vbartusevicius/esp-measurement-platform/hardware/releases/v1/README.md

# ESP Measurement Platform Hardware v1 (1-DIN Universal Sensor Node + Plugin Enclosures)

Generated by `python3 hardware/scripts/build.py` from `hardware/circuits/variants/v1/` and `mechanical/scripts/`.
Release gate: KiCad DRC with 0 errors and 0 unrouted connections, pin-for-pin JLCPCB / EasyEDA footprint and
pin-name verification with live stock for every JLC-placed part, and the CadQuery fit tests in `mechanical/tests/`.
Independent pre-order review: `.claude/skills/manufacturing-readiness-review/` (run it before every order).

| View | Render |
| :---: | :---: |
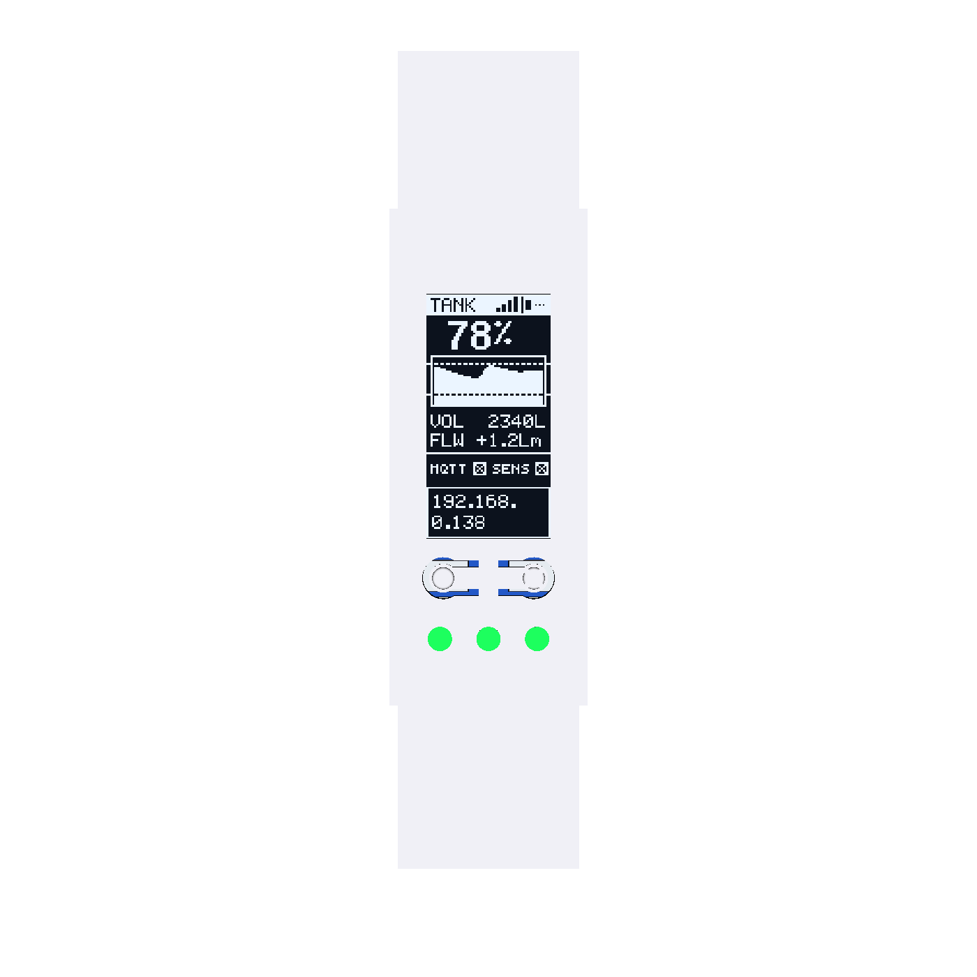
[picture p14: hardware/releases/v1/enclosure/renders/front.png]
Front
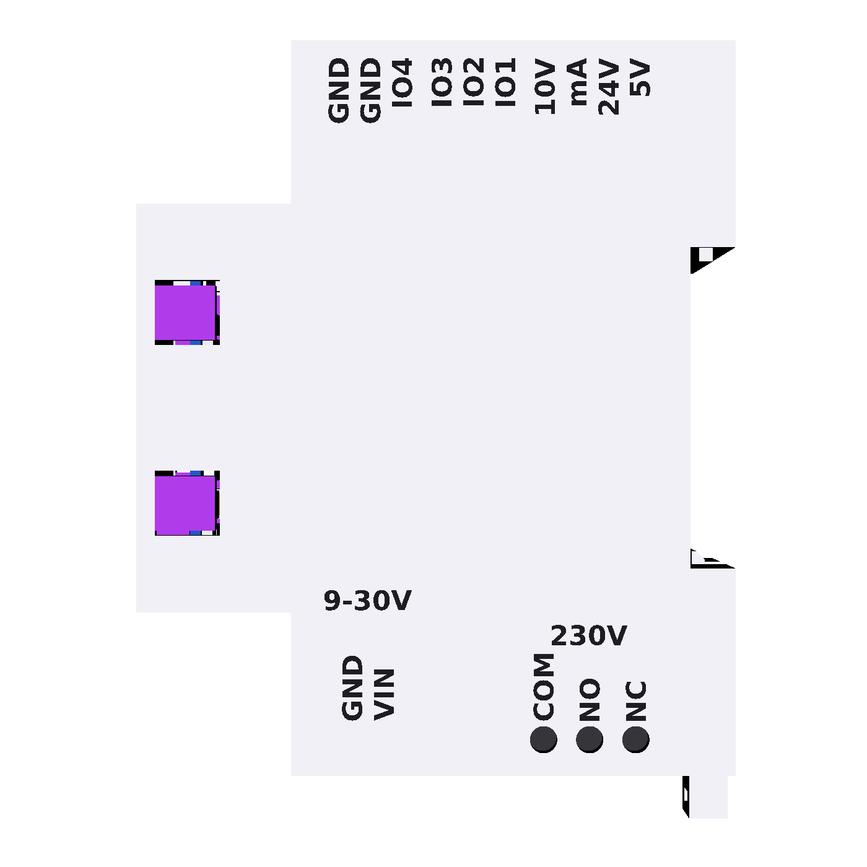
[picture p15: hardware/releases/v1/enclosure/renders/side.png]
Side
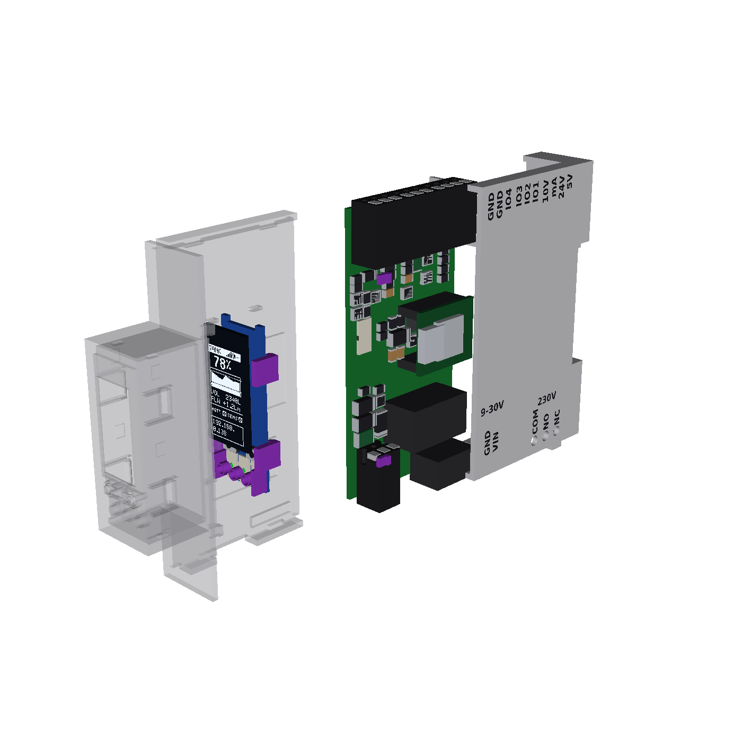
[picture p16: hardware/releases/v1/enclosure/renders/exploded.png]
Exploded
| **1-DIN Universal Sensor Node (Front, Side Legend & Exploded)** |    |
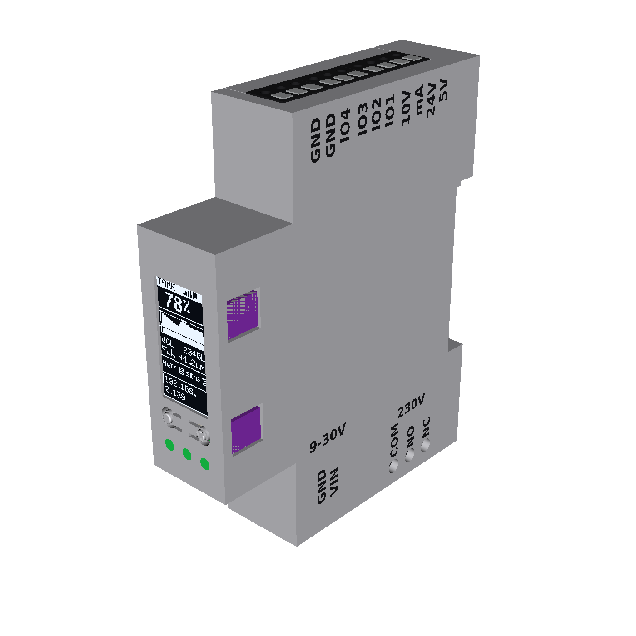
[picture p17: hardware/releases/v1/enclosure/renders/iso.png]
Iso
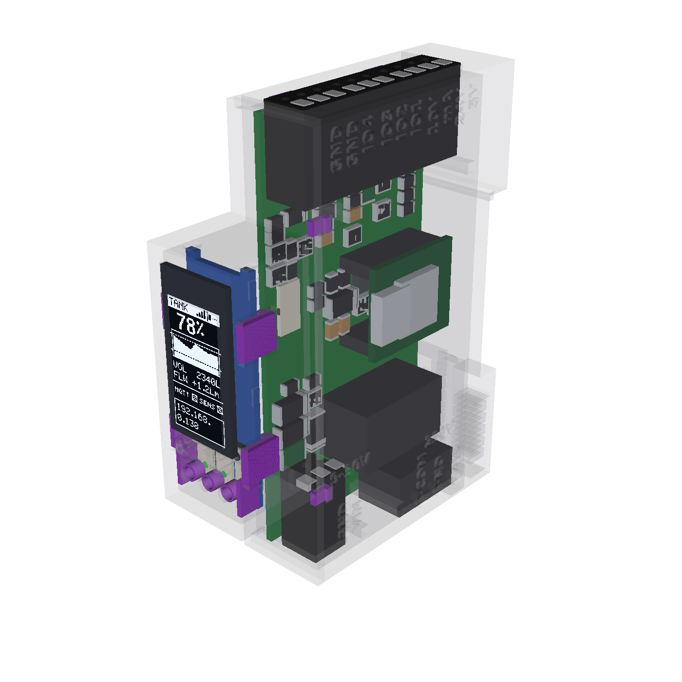
[picture p18: hardware/releases/v1/enclosure/renders/inside.png]
Inside
| **1-DIN Isometric & Internal Layout (`main` + `ui`)** |   |
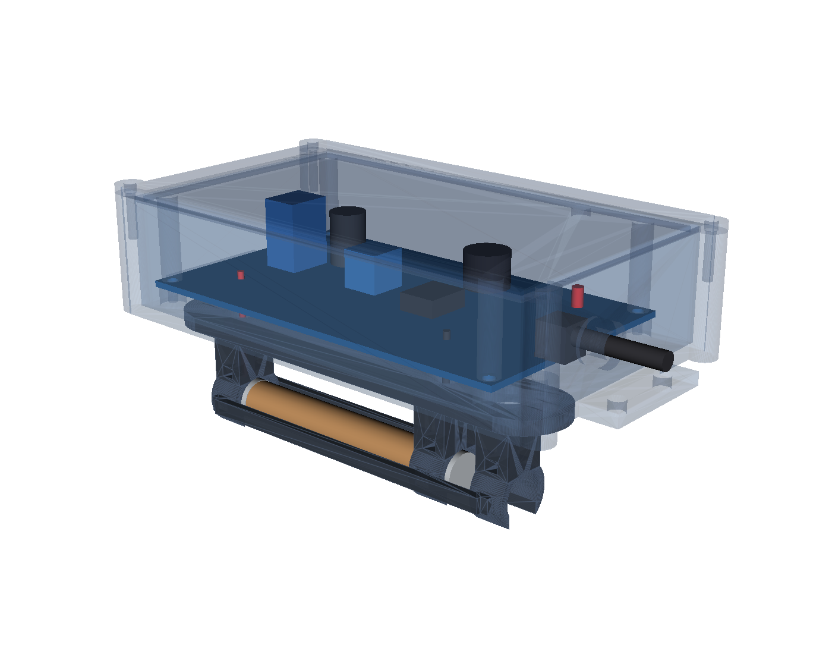
[picture p19: hardware/releases/v1/accessories/radiation_duct/renders/radiation_inside.png]
Radiation Inside
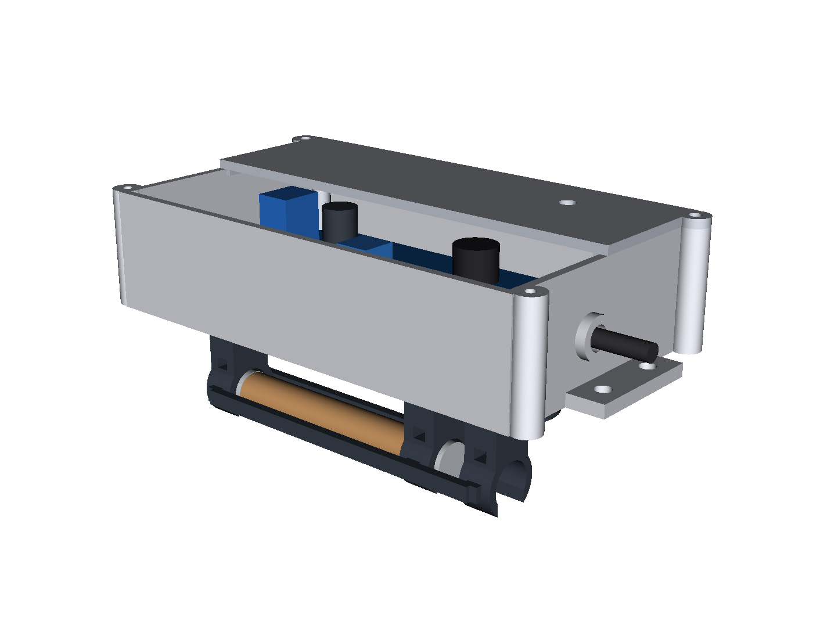
[picture p20: hardware/releases/v1/accessories/radiation_duct/renders/radiation_assembled.png]
Radiation Assembled
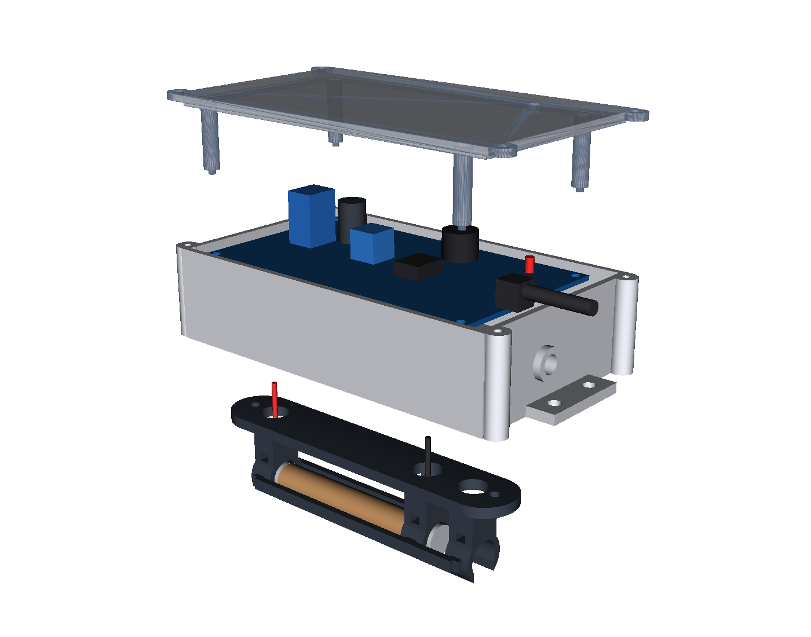
[picture p21: hardware/releases/v1/accessories/radiation_duct/renders/radiation_exploded.png]
Radiation Exploded
| **Radiation Counter Airduct Assembly** |    |
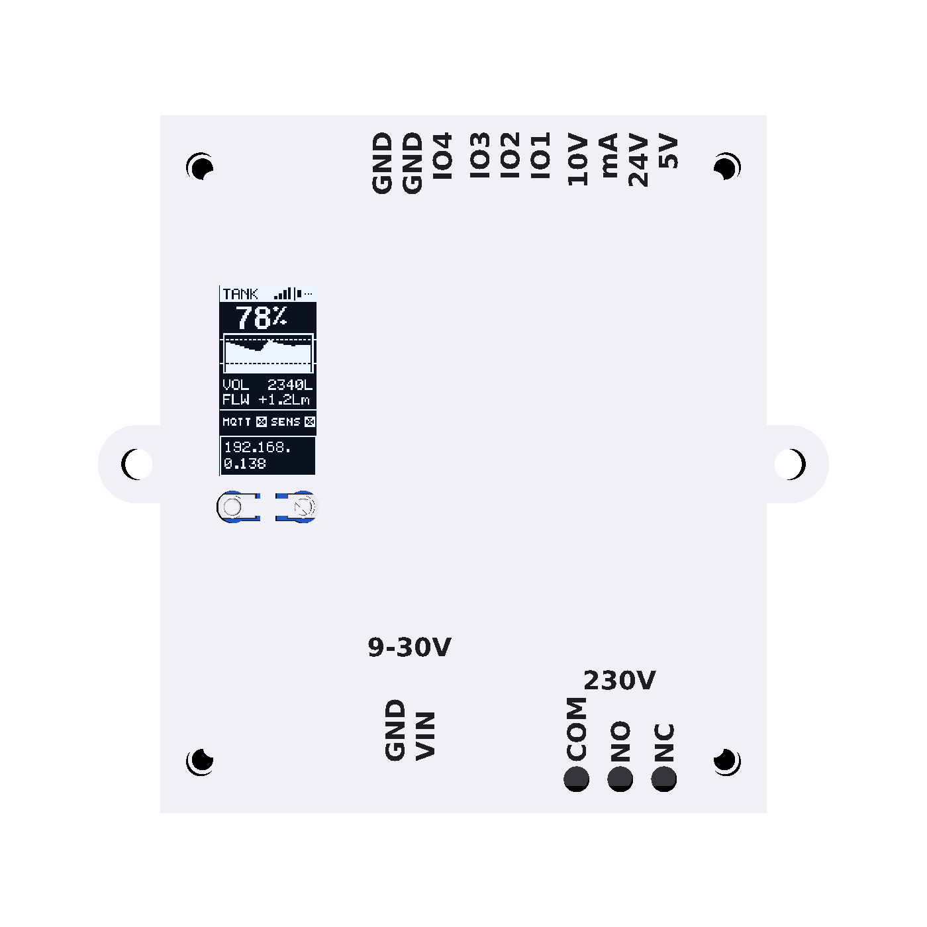
[picture p22: hardware/releases/v1/box_enclosure/renders/box_front.png]
Box Front
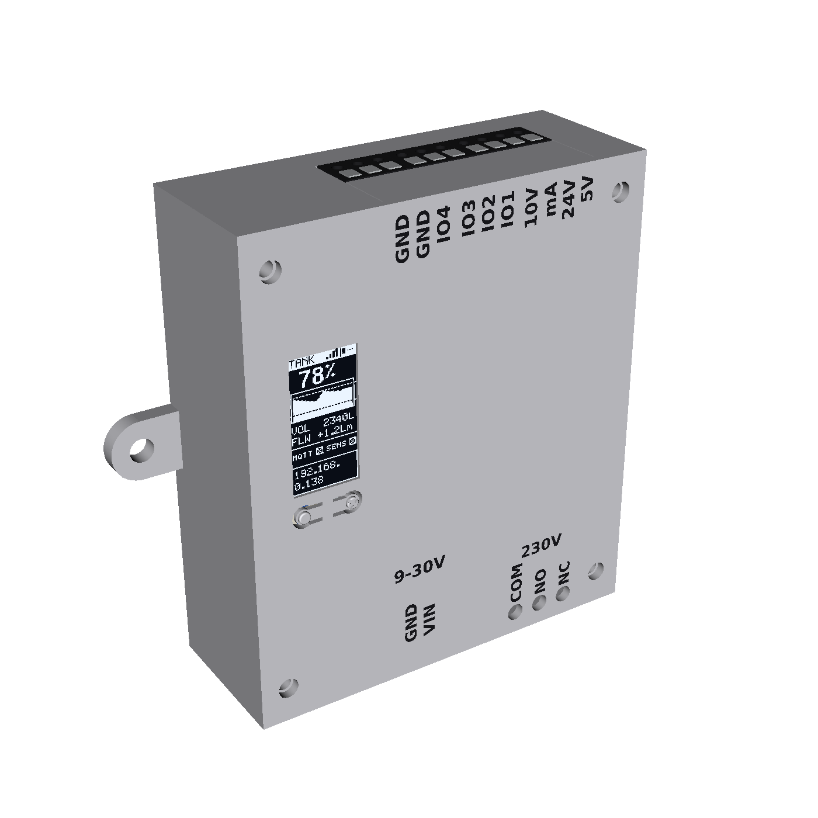
[picture p23: hardware/releases/v1/box_enclosure/renders/box_iso.png]
Box Iso
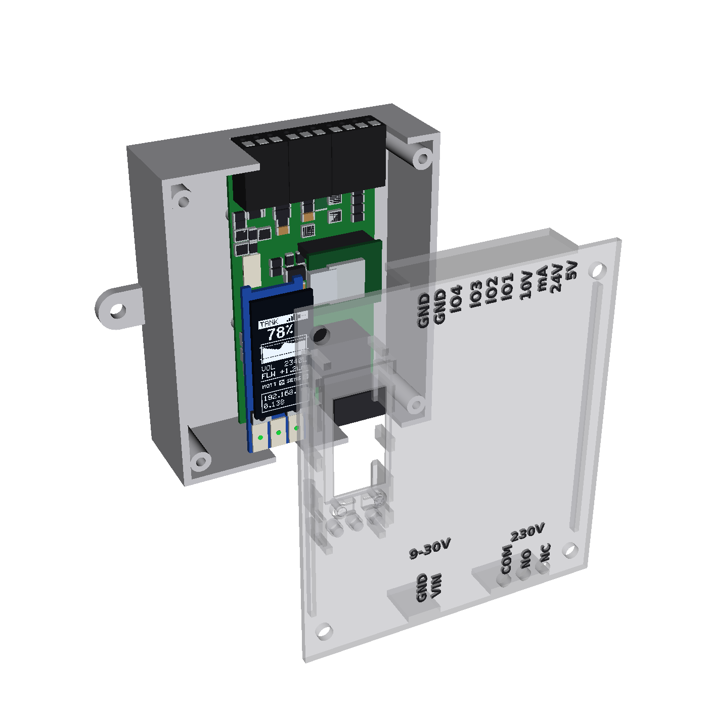
[picture p24: hardware/releases/v1/box_enclosure/renders/box_exploded.png]
Box Exploded
| **Wall-Mount Box (non-DIN alternative)** |    |
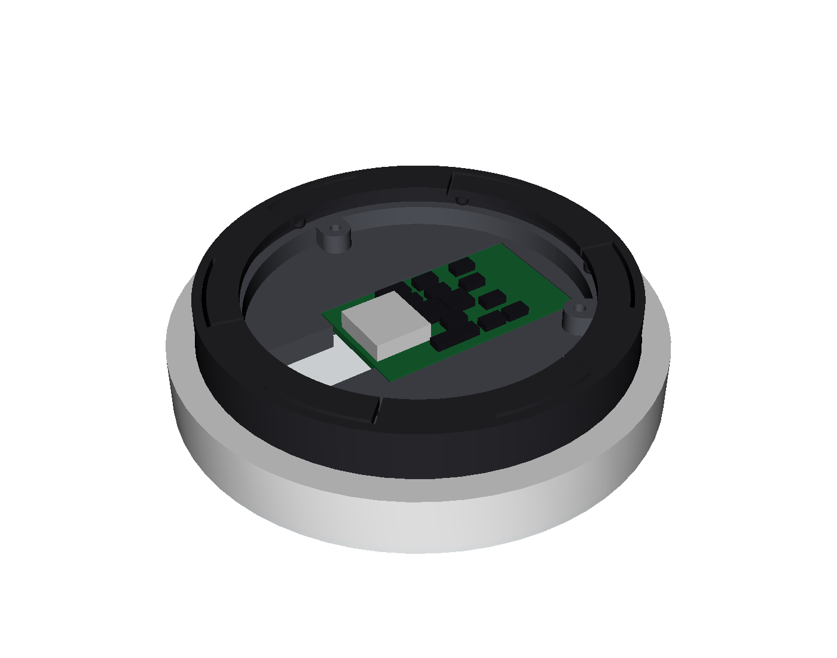
[picture p25: hardware/releases/v1/accessories/dial_reader/renders/dial_reader_inside.png]
Reader Inside
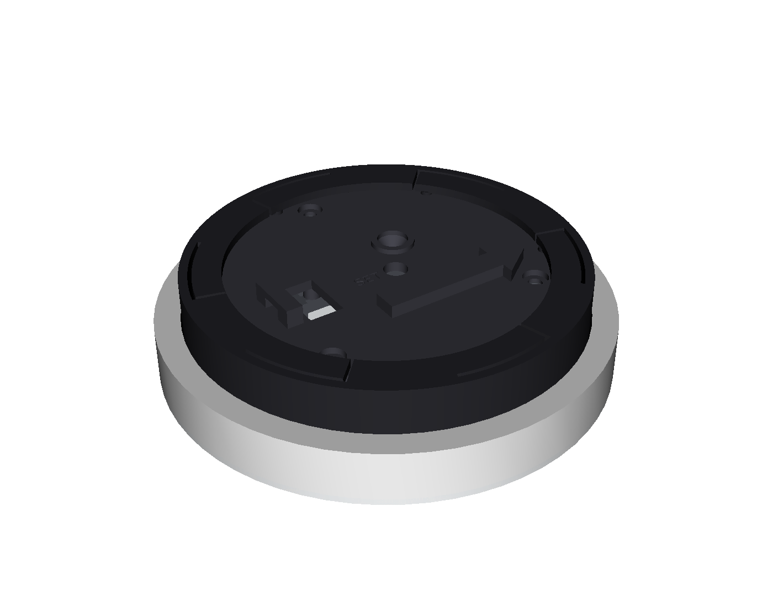
[picture p26: hardware/releases/v1/accessories/dial_reader/renders/dial_reader_assembled.png]
Reader Assembled
| **Optical Dial Reader (water / gas / oil dials)** |   Reader Exploded |
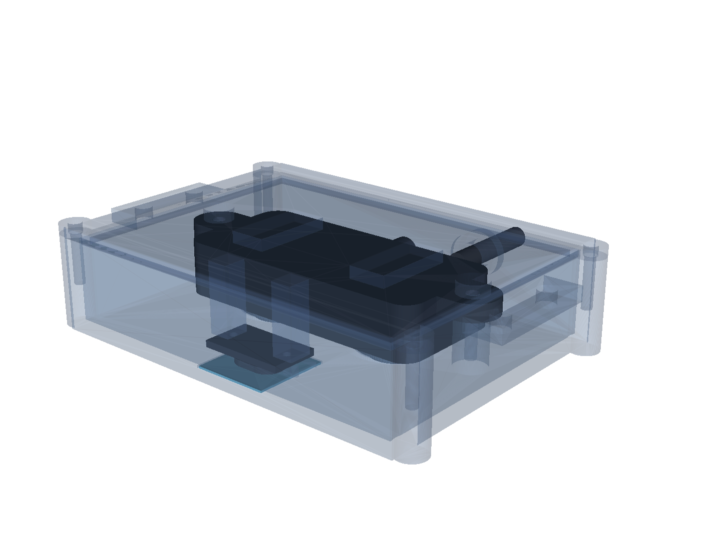
[picture p27: hardware/releases/v1/accessories/distance_sensor_pod/renders/distance_pod_inside.png]
Distance Pod Inside
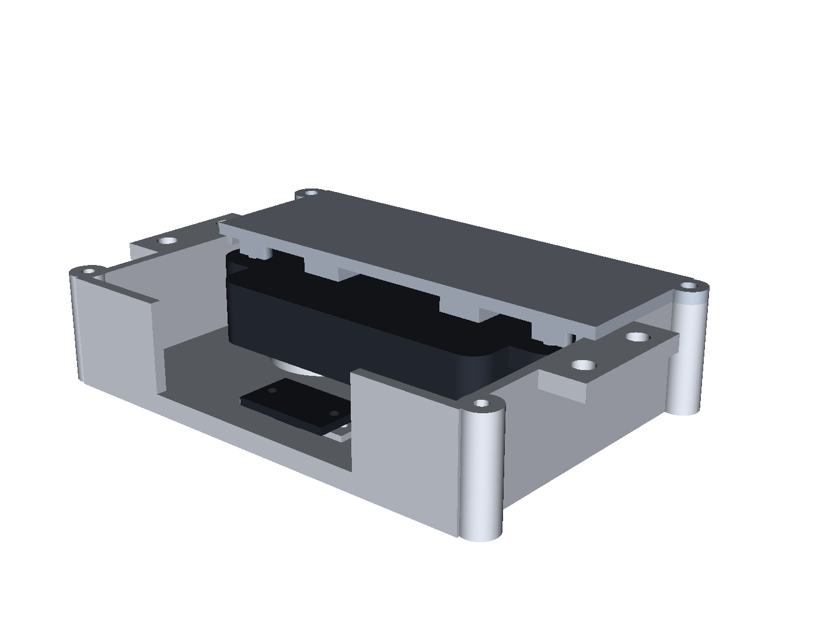
[picture p28: hardware/releases/v1/accessories/distance_sensor_pod/renders/distance_pod_assembled.png]
Distance Pod Assembled
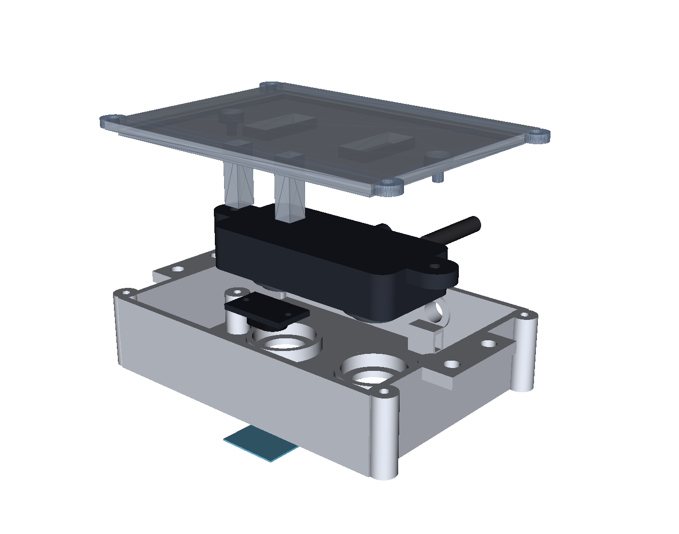
[picture p29: hardware/releases/v1/accessories/distance_sensor_pod/renders/distance_pod_exploded.png]
Distance Pod Exploded
| **Universal Distance Sensor Pod** |    |

### Which files to upload

Every board folder (`main/`, `ui/`, `reader/`) holds the same set; `<b>` is the board name.

| Fab | Bare PCB | Assembly (PCBA) |
|---|---|---|
| **JLCPCB** | `<b>_gerbers.zip` (or `panel/panel_gerbers.zip` for `main` + `ui` in one order) | `<b>_bom_jlc.csv` + `<b>_cpl_jlc.csv`: LCSC numbers, rotations and centres fitted to JLC's own footprints |
| **AISLER** | `<b>_odb.zip` (ODB++) | the same `<b>_odb.zip`: AISLER assembles only from ODB++ or native files, not from Gerbers. Parts auto-assign from the `MPN` field; hand-fit parts carry ODB++'s `.no_pop` flag |
| **Eurocircuits** | `<b>_odb.zip` or `<b>_gerbers.zip` | `<b>_bom.csv` + `<b>_cpl.csv` (they ignore the BOM inside CAD data and ask for a separate one) |
| **PCBWay** and most others | `<b>_gerbers.zip` | `<b>_bom.csv` + `<b>_cpl.csv`; `<b>_ipc2581.zip` (IPC-2581 C with the BOM) where accepted |

- **`<b>_gerbers.zip`:** Gerber X2 copper, mask, paste, silkscreen and outline, Excellon drills with plated and non-plated holes in separate files, the Gerber job file, and `<b>-netlist.ipc` (IPC-D-356) for the electrical test.
- **`<b>_bom.csv`:** grouped by part: Qty, Designator, Value, Manufacturer, MPN, LCSC, Package, SMD/THT, Place (`NO` = hand-fitted after assembly, e.g. the XIAO module) and a description.
- **`<b>_cpl.csv`:** every machine-placed part (hand-fit parts left out) in mm, in the Gerbers' coordinates. Rotations follow KiCad's footprint orientation: check polarised parts in the fab's placement preview, as with JLC.
- **Panel:** only JLCPCB gets the ready-made `main` + `ui` panel; other fabs take the two boards as separate designs.

### Parts for assembling one device yourself

**Where each part goes:** `<board>/<board>_assembly.pdf` (main, ui, reader). It has one page per populated side (the bottom is mirrored, as seen from below). Each page shows every part's outline with its reference and value, a red dot on pin 1 and `*` on hand-fitted parts. Parts of the same value share a colour. The last page lists the values with their colour, quantity, side and references, so you can solder one value at a time. Use it wherever the silkscreen reference had to be hidden. The PDF is vector, so zoom in on the small parts.

`hardware/scripts/parts_orders.py` writes these with every release and looks every LCSC number up live on LCSC: it reports numbers that don't exist, aren't on sale or are short of the quantity. Quantities cover one complete device (`main` + `ui` + `reader`).

| File | Upload to | Map the columns |
|---|---|---|
| `order_lcsc.csv` | [LCSC BOM Tool](https://www.lcsc.com/bom) | **LCSC Part Number** → "LCSC Part #", **Quantity** → "Quantity". Optional: **Manufacturer Part Number** → "Manufacture Part #", **Designators** → "Customer #" / comment. Leave **Value** and **Footprint** unmapped. LCSC raises each line to its minimum order itself (e.g. 100 for 0603 resistors). |
| `order_elsewhere.csv` | Electronics LCSC doesn't sell: pick one shop per line ([Mouser BOM Tool](https://www.mouser.com/bom/), [Digi-Key BOM Manager](https://www.digikey.com/en/mylists/), TME by hand) | Map that shop's column (**Mouser**, **Digi-Key** or **TME**) to its part-number field and **Quantity** to quantity. A line can list numbers at several shops; **Other source** is filled only when no shop number exists (the OLED). Includes the three WAGO terminal blocks: JLCPCB assembles them, but LCSC doesn't sell them. |
| `assembly_parts.csv` | — | Everything off the boards: modules, cables, printed parts and general utility items (foam tape, ...). Utility and printed items appear only here. |

- **One line per LCSC number** in `order_lcsc.csv`, with designators as `board:ref` (`off-board` for the XIAO sockets and the FFC cable).
- **Not in the order files:** printed parts and general utility items (tapes, screws); they are listed in `assembly_parts.csv`.
- **LCSC replacements (2026-10-29):** LCSC had no stock of C14663, C25804 and C28323 and doesn't sell C82401, all four only in JLCPCB's own assembly library. They were replaced in the circuit (`hardware/circuits/common.py`, `blocks/power_24v.py`) by same-package, same-rating parts both LCSC and JLCPCB stock:
  - C14663 → C149620 (YAGEO AC0603KRX7R9BB104, 100 nF 50 V X7R 0603);
  - C25804 → C98220 (YAGEO RC0603FR-0710KL, 10 kΩ 1 % 0603);
  - C28323 → C91185 (YAGEO CC0805KKX7R9BB105, 1 µF 50 V X7R 0805);
  - C82401 → C167838 (CJ FNR4020S220MT, 22 µH 4×4×2.0 mm shielded, 1.1 A Isat, 0.87 A Irms, 455 mΩ; the Sunlord part was 1.05 A / 0.62 A / 455 mΩ).
- **Distributor numbers:** checked by hand on 2026-10-29 and stored in `hardware/scripts/gen_circuits.py` (off-board parts) and `hardware/product/lcsc_unavailable.yaml` (assembled parts LCSC doesn't sell). Mouser and Digi-Key block automated lookups, so only the LCSC numbers are re-checked on each release.

---

## 1. Universal 1-DIN (`18 mm`) Sensor Controller (`main` + `ui`)

| Board | Size | Layers | Thickness | Role | Folder |
|---|---|---|---|---|---|
| **Breakaway Panel (`panel`)** | see `panel/` | 4 | 1.2 mm | Combined `main` + `ui` with mouse-bite tabs (1 PCB + 1 PCBA order) | `panel/` |
| Main (`main`) | 39.8 × 77.4 mm | 4 | 1.2 mm | Vertical board along the left wall (0.2 mm clearance to the 77.8 mm cavity at both ends). 24 V input: 1.1 A PTC, `SS36` 60 V reverse-polarity Schottky, `SMAJ30A` TVS (48.4 V clamp); `SCT2601` 4.5–60 V (65 V abs max) 700 kHz buck → 5.05 V / 600 mA with `SS36` catch diode and 22 µH `FNR4020S220MT` (4×4×2 mm, drop-in for Sunlord `SWPA4020S220MT`); `SS34` Schottky (SMA) into the XIAO ESP32-C6 (on 5 mm female headers); passives 0805 or larger for hand soldering; dedicated 4–20 mA input (50 mA PTC + 120 Ω shunt); 0–10 V input (22 k / 10 k); four protected digital channels (IO1–IO4); all six signal inputs clamped to GND/+3V3 by `BAT54S` (2 µA, 10 pF max); Omron `G6B-2114P-US DC5` relay (1a + 1b joined as a changeover) for **230 VAC loads up to 2 A**, 6 mm creepage + milled slot to the SELV side, 2.5 mm between the relay nets | `main/` |
| UI (`ui`) | 13.8 × 40.5 mm | 4 | 1.2 mm | 0.96" 64×128 SSD1312 OLED (`QG-6428TSWCG02` / `JLX12864OLED-S096W` / `NFP1312-15AY`, 14-pin 0.62 mm solder-tail FPC on `J2`), two Omron `B3U-1000P` switches under C-shaped spring tabs in the front wall, three `WS2812B-MINI-V3J` RGB LEDs with gull-wing legs below them, 0805 passives, 8-pin 0.5 mm FFC (`J1`) to `main J3` | `ui/` |

### Terminal Pinout & Plugin Wiring

Every wire enters parallel to the board, through the top or bottom face of the case.

- **Push-in terminals:** WAGO 2086 3.5 mm SMD, with the release push-buttons in the wire-entry face (300 V / 10 A UL, 0.14–1.5 mm², strip 8–9 mm). Top bank: `J2`, `J5`, `J6`, JLC-assembled. Bottom: `J1` (2086-1202), hand-soldered because JLC has no stock.
- **`J4` (230 V relay):** a Degson `DG127R-5.08-03P` screw terminal (IEC 250 V / 15 A, 0.75–1.5 mm², strip 6–7 mm, M2.5 at 0.4 N·m), JLC-assembled. Its screws are turned through the three holes in the case's right side, under the COM / NO / NC labels.
- **Why not push-in on `J4`:** a 5 mm push-in terminal rated ≥ 250 V would need its release where you can reach it in an 18 mm case. The Kefa KF142R's levers stand 13.7 mm, beyond the case side, where the next DIN module would hold them open; the one fitting Phoenix SPT-SMD part is sold only in reels of 300.

| Terminal | Location | Poles | Function |
|---|---|---|---|
| **Sensor bank: `J2` (2086-1204) + `J5` + `J6` (2086-1203) = 10 poles** | Top | **`1: +5V`** · **`2: +24V`** · **`3: 4-20mA`** · **`4: 0-10V`** · **`5: IO1`** · **`6: IO2`** · **`7: IO3`** · **`8: IO4`** · **`9: GND`** · **`10: GND`** | `1: +5V` (600 mA shared with the controller); `2: +24V` (input after PTC + reverse diode, loop supply); `3: 4-20mA` (`D1/GPIO1/ADC1_CH1`: 50 mA PTC, 120 Ω shunt, 4 mA = 0.48 V, 20 mA = 2.40 V, 24 mA = 2.88 V, 10 k + 100 nF RC); `4: 0-10V` (`D0/GPIO0/ADC1_CH0`, 22 k / 10 k divider, 10 V = 3.125 V); `5: IO1` (`D7/GPIO17`: ECHO / SDA / RX); `6: IO2` (`D6/GPIO16`: TRIG / SCL / TX); `7: IO3` (`D9/GPIO20`: Geiger PULSE); `8: IO4` (`D10/GPIO18`: meter pulse); IO lines: 4.7 k pull-up to 3.3 V, 330 Ω series, `BAT54S` clamp |
| **`J1` (2P)** | Bottom front | **`1: GND`** · **`2: VIN+`** | `9–30 V DC`; 1.1 A PTC, `SS36` reverse protection, `SMAJ30A` surge clamp |
| **`J4` (3P)** | Bottom rear | **`1: COM`** · **`2: NO`** · **`3: NC`** | **230 VAC, 2 A resistive / 1.5 A inductive (cos φ 0.4)**. Omron G6B-2114P: 5 A 250 VAC rated, 3,000 VAC for 1 min and 6 kV impulse between coil and contacts, 11.0 mm tall. Coil pads sit 10.16 mm from the contact pads, with ≥ 6 mm PCB creepage and a milled slot. Fuse the load circuit at ≤ 2 A. The relay is off at power-up and after every reset. |

1. **2-wire 4–20 mA probe (e.g. `SWK-LT100`):** `Red (+)` → pole `2 (+24V)`, `Black (-)` → pole `3 (4-20mA)`. Loop compliance at 20 mA ≈ V<sub>IN</sub> − 0.5 V (diode) − 1.0 V (PTC) − 2.4 V (shunt): ≥ 20 V at 24 V input, ~8 V at 12 V input — check the transmitter's minimum supply.
2. **`0.4–4.5 V` (150 PSI) or `0–10 V` / `2–10 V` sensor:** `+5V`/`+24V` supply, `GND`, signal → pole `4 (0-10V)`. Ratiometric 5 V sensors follow the ±2.5 % buck tolerance (5 V is not measured).
3. **ToF `VL53L1X`/`TOF200C` (I²C) or `A02YYUW` (UART):** `VCC` → pole `1`, `GND` → pole `9`, `SDA/TX` → pole `5 (IO1)`, `SCL/RX` → pole `6 (IO2)`. Keep I²C cables short (≤ 1 m at 100 kHz with the 4.7 k pull-ups).
4. **CAJOE `RadiationD-v1.1`:** `+5V` → pole `1`, `GND` → pole `9`/`10`, `VIN (PULSE)` → pole `7 (IO3)`.
5. **Meter pulse emitter (B METERS `IWM-PL3`, open collector, max 30 V / 100 mA):** `White` (counting contact) → pole `8 (IO4)`, `Brown` (common) → pole `9`/`10 (GND)`; yellow and green unused. The 4.7 k pull-up gives 0.7 mA through the closed contact.
6. **230 VAC load on the relay:** phase from a ≤ 2 A fuse/MCB → `J4.1 (COM)`, load → `J4.2 (NO)` (or `J4.3 (NC)` for normally-on), load return to neutral directly (not through the device). Use 0.75–1.5 mm² wire, strip 11 mm. Control it from Home Assistant (auto-discovered **Relay** switch) or MQTT `<device_name>/relay/set` = `ON`/`OFF`; state on `<device_name>/relay`.

> **Mains safety:** installing this requires a qualified person and a closed distribution board.
> - **Enclosure material:** print the enclosure in a flame-retardant filament (UL94 V-0, e.g. PC-FR or PETG-V0) when J4 carries mains. Plain PETG/ASA is not flame-rated.
> - **Insulation:** the G6B's 3 kVAC / 6 kV coil–contact insulation plus the 8 mm PCB creepage is the barrier between 230 V and the SELV side. Omron does not market the G6B as "reinforced", and nothing here is a certified product.

---

### Printing the 1-DIN case (`enclosure/`, `box_enclosure/`)

- **Process:** sized for powder printing (MJF / SLS, PA12). Every gap inside one printed part is at least 0.6 mm (`MIN_PRINT_GAP`): the DIN latch and its springs, the button C-slots, the UI snap-tongue slots. The 0.2 mm clearances (`FDM_CLEAR`) are only between separately printed parts or between a part and a PCB / terminal body, which cannot fuse.
- **DIN latch:** a 3.6 mm bar on two 11-leg serpentine springs (0.6 mm legs, ≤ 2.5 % strain over the 1.8 mm release travel). Release it with a flat screwdriver in the 3.0 × 1.6 mm hole of the tab below the case.
- **Cover:** six snap clicks (two on the right wall, a pair at each end of the left edge). Its locating lip is bonded to the side wall along its length and notched clear of the snap tongues. Ribs on its left wall back the main board at least every 40 mm, and four base posts support the board's front face, 0.1 mm short, in part-free columns.
- **Front:** no text. The buttons are told apart by their pads: the plain round bump (●) is the page / acknowledge button, the bump with a recessed ✕ (1.5 mm bars, 0.5 mm wide, 0.35 mm deep) is reset / WiFi (tap: reboot; hold 5 s: WiFi setup; hold 15 s: factory reset). The three LEDs are unmarked: STATUS, NET, SENS from left to right. The UI board is held off the front by edge stops beside the LED row.
- **Right side face:** each terminal pole's name is engraved beside it, 3 mm. The sensor bank reads 5V, 24V, mA, 10V, IO1–IO4, GND, GND for poles 1–10, bottom to top along the rail axis. J1 reads GND, VIN under "9-30V", and J4 reads COM, NO, NC under "230V".
- **Terminal access:** `J1`'s push-buttons are in its wire-entry face, so the bottom-wall slot exposes them. `J4`'s screws face the right wall: a 3.0 mm hole over each takes a 2.5 mm flat blade. The screw heads stay 1.5 mm inside the wall, so an IP20 test finger cannot touch them. Wire `J4` before mounting the next DIN module beside it.

## 2. Printable Enclosures & Plugin Accessories

- **`enclosure/`** — 1-DIN (`18 mm`) side-opening clamshell (`base.stl`, `cover.stl`, `assembly.step`), PETG/ASA, 0.2 mm layers.
  - **Assembly:** solder the XIAO sockets, clip all THT solder tails on the back of `main` to ≤ 2.5 mm, slide the populated `main` into the base from the open left side (the terminal blocks run into the top/bottom wall slots, 0.2 mm clearance all round). Stick two strips of 3.0 mm foam tape on the UI board front under the OLED's long edges (on top of the panel's 1.0 mm VHB), snap the UI board into the cover, fit the FFC, then slide the cover on from the left until the four side hooks click. The cover's filler bars close the terminal slots and its side wall has recesses over the THT tails.
  - **Front:** the OLED panel face sits in a 1.0 mm pocket behind the active-area window, pressed forward by the foam; the two buttons are C / mirrored-C spring tabs in the front wall (same design as knx-dali-gateway v3): a 0.7 mm pad on an arm rooted at a shared centre bridge, a rounded 0.6 mm bump on the front for the finger, and a plunger behind ending 0.1 mm above the B3U actuator (no separate parts); LEDs shine through 0.6 mm skins inside baffles.
- **`box_enclosure/`** — wall-mount alternative to the DIN case for the same boards (no PCB changes): `box_base.stl` (back tray with the wall ears) and `box_lid.stl` (the face), 26.4 × 81 × 70.4 mm (93.4 mm wide over the ears), PETG/ASA, 0.2 mm layers, lid face down on the bed.
  - **Layout:** the face is the plane of the DIN case's debossed legend (parallel to `main`) and carries the same terminal legend. Left of it (front view) sits the UI front of the DIN cover (OLED pocket + window, C-shaped button tabs with plungers, LED baffle windows, edge stops, ● / ✕ button pads), rotated 90° to face the lid, ≥ 3 mm from the legend; the UI board's back-side parts are 1.0 mm above the tallest `main` parts (relay, XIAO).
  - **Assembly:** solder the XIAO sockets, clip THT tails to ≤ 2.5 mm, drop the populated `main` straight into the tray (terminal blocks into the top/bottom wall openings, 0.2 mm clearance; the board rests on four posts). Foam-tape the OLED as for the DIN cover, snap the UI board into the lid (four arms hook behind it, blocks locate it within 0.15 mm), fit the same 50 mm FFC (about 32 mm of route with right-angle folds; this fold differs from the DIN case, so check the Type A/B contact side for it too), close the lid (its bars press on the terminal blocks) and fit 4 × M3 × 10 pan-head screws for plastic (2.5 mm pilots, 10 mm deep, in the corner bosses).
  - **Mounting:** one ear on each side at mid-height, Ø 4.0 mm holes 6.5 mm out from the side walls, 83.4 mm apart (3.5 mm wood screws or M3.5). Wires leave through the top (sensors) and bottom (power, relay) faces.
  - **Mains:** the same V-0 filament rule applies when `J4` switches 230 VAC, and the box must be installed where its terminals are not touchable (behind a cover or in a closed cabinet), because the terminal faces are open like on the DIN case.
- **`accessories/radiation_duct/`** — CAJOE box (`cajoe_box_base.stl`, `cajoe_box_cover.stl`) mounted outside a ventilation duct and an in-duct tube bracket (`duct_tube_bracket.stl`) holding the bare J305 tube. See limitations below.
- **`accessories/distance_sensor_pod/`** — lid-mount pod for a `VL53L1X`/`TOF200C` ToF board and/or an `A02YYUW` ultrasonic sensor (`distance_pod_base.stl`, `distance_pod_cover.stl`).
- **`accessories/dial_reader/` + `reader/` (separate PCB order, not on the panel)** — optical dial reader: a pulse emitter for mechanical meters with a reflective (metal) half-disc or pointer under flat glass (water, gas, oil), fitted first to a B METERS GMDM dial in place of an IWM-PL3. Black (IR-opaque) PETG/ASA, 0.2 mm layers.
  - **Board (`reader/`, 31.5 × 18 mm, 4 layers, 1.2 mm, JLC-assembled incl. the THT sensor):** Vishay `TCRT5000` on the back, 0.5 mm above the glass over the wheel (axis 20.5 mm from the dial centre on the GMDM; both spots 4.9 mm from the axis). TI `LMV331` comparator, 80 mV hysteresis, `TC33X` threshold trimmer, red indicator LED (on while the output is low), `B5819W` reverse-polarity diode, open-collector output through 330 Ω. All front parts ≤ 2.7 mm. `J1` WAGO `2059-303` SMD push-in (solid 0.14–0.34 mm², strip 4–5 mm, release with a pin in the round hole): `1 +5V`, `2 GND`, `3 PULSE` → sensor bank poles `1`, `9`/`10`, `8 (IO4)`. About 22 mA at 5 V.
  - **Carrier (`dial_reader_carrier.stl`):** a plain Ø52.0 × 11.8 mm cylinder (the closed carrier with its lid is Ø52.0 all the way up) standing on the glass inside the hooks, which centre it. The PCB sits on rails in a pocket that keeps it square; three U-shaped screw bosses are tied into the wall.
  - **Lock ring (`dial_reader_ring.stl`, skirt down):** Ø62.0 × 15.2 mm, 0.25 mm inside the dial's rotating white ring, which it never needs. It goes on last, straight down over the closed carrier: its tabs and stop ribs reach in only to r 27.25 mm, outside the carrier's r 26.0. The skirt drops into the 1.5 mm gap outside the three clear hooks; three tabs slide under the hooks' 2 mm lips as it turns **22° counter-clockwise** and a rib behind each tab stops the turn. Six spring fingers in its top flange (inner edge r 24.6) press on the lid's outer rim (bump interference 0.9 mm at rest, about 0.6 mm when the tabs bear on the lips). The carrier still turns through 360° under them, so the sensor can be swung exactly over the wheel after the ring is locked.
  - **Lid (`dial_reader_lid.stl`, top down):** Ø52.0 mm, rim pressed by the ring's fingers; four posts press the PCB onto its rails, 3 × M2 × 6 self-tapping screws. Cable hole over the terminal's wire entries, LED and trimmer holes, zip-tie bridge, and an arrow-shaped grip bar (pointing at the sensor) to turn the carrier by.
  - **Fit first:** `dial_reader_test_ring.stl` is the bottom 6 mm of the ring: check the twist lock on the meter before printing the rest. The hook geometry comes from caliper measurements and photos (hook 10.5 × 3.3 × 4 mm, lip 2 mm, notch 1.5 mm, outer face 29.75 mm from the centre, hooks at 180° and ±60° from the wheel).
  - **Setting up:** see the root README, *Pulse meter → optical dial reader*.
---

## 3. Open items before ordering (not verifiable from this repository)

- **Firmware:** `pio run -e xiao_c6` builds for this board; see the root README for the pin map and behaviour. Untested on hardware: OLED rotation (`U8G2_R1`, swap to `U8G2_R3` if upside down), the ADC thresholds of the button ladder, and the WS2812B-MINI-V3J colours.
- **OLED:** pinout verified against the JLX12864OLED-S096W drawing (JLX, 2025-09-17): 1 C2P, 2 C2N, 3 C1P, 4 C1N, 5 VBAT (= VDD), 6 NC, 7 VSS, 8 VDD 3.3 V, 9 RES#, 10 SCL, 11 SDA, 12 IREF (390 k to VSS), 13 VCOMH, 14 VCC; tail 12.0 × 9.3 mm, 14 fingers 0.32 mm at 0.62 mm pitch. Pin 1 is on the right in the front view, which lands on the right (x = 10.93 mm) of `ui J2` after the fold, as placed. The tail-to-pad reach still depends on how tightly the tail is folded; the 2.5 mm pads leave some margin.
- **FFC:** confirm the contact side (Type A/B) of the 50 mm cable against the two connectors' contact sides with a paper mock-up of the fold.
- **WAGO sensor bank:** the 4-pole and two 3-pole blocks are separate, placed butted with 0.15 mm gaps (pole spacing 4.2 mm across each joint). JLCPCB stocks 146 × `2086-1204` and 173 × `2086-1203` (enough for prototypes, not volume). EasyEDA has no footprint for `2086-1203` (C3309626): its land pattern is the 4-pole one's per pole (cited in `hardware/product/pinouts.yaml`). **Check the rotation of `J5`/`J6` in JLCPCB's placement preview:** wire entries face the board edge, like `J2`.
- **Radiation duct:** a glass-walled GM tube measures ambient gamma background; it does not measure radon in the air stream. The flat box base needs a gasket or saddle on a round duct, and the 400 V tube leads in humid duct air can leak.
- **Distance pod:** condensation or salt crust on the ToF window gives short readings; the ultrasonic beam can echo off the tank walls.
- **Dial reader:** the IR contrast between the metallic half-disc and the white dial through the glass, and the distance (glass thickness + gap, estimated 4–6 mm, TCRT5000 output falls to roughly 40–50 % of its 2.5 mm peak there), are unverified: hold a TCRT5000 module over the turning wheel with a multimeter before ordering. Check `U1` (bottom side) in JLC's placement preview.
- Order 5 bare prototypes and print one enclosure set first; run a 24 V mis-wire test on sensor pole `3 (4-20mA)` (PTC trip) and a surge test on `J1`.
