vbartusevicius/esp-measurement-platform/hardware/releases/v1/enclosure/front_legend.pdf

10 mm (1:1); cyan = guides, not printed

ESP Measurement Platform v1 front legend, front view
