vbartusevicius/esp-measurement-platform/doc/admin_dashboard.png

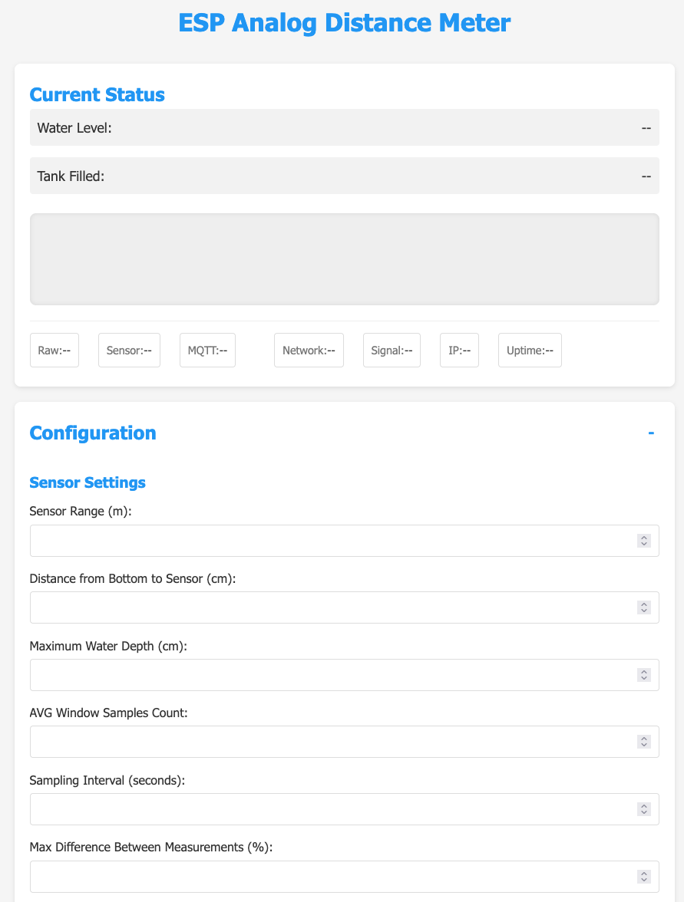
doc/admin_dashboard.png
