vbartusevicius/esp-measurement-platform/doc/analog_sensor.png

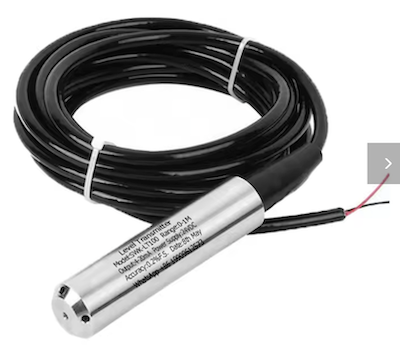
doc/analog_sensor.png
