vbartusevicius/esp-measurement-platform/doc/ha_device.png

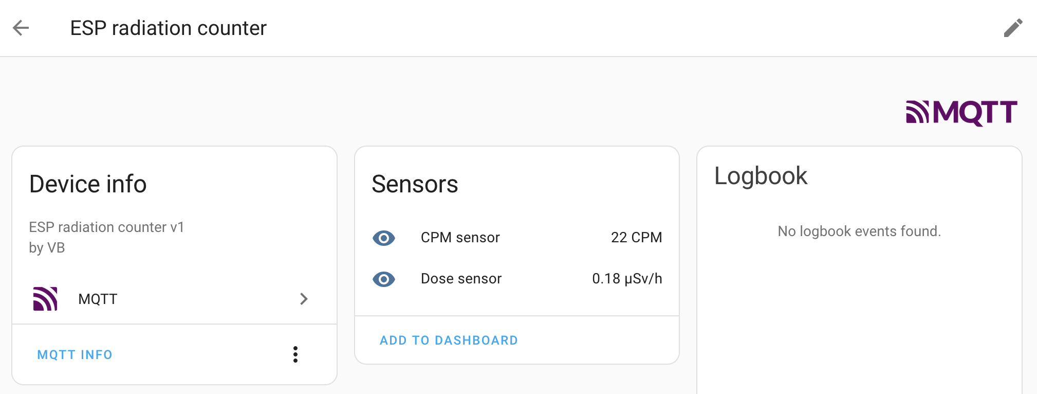
doc/ha_device.png
