vbartusevicius/esp-measurement-platform/doc/nodemcu.png

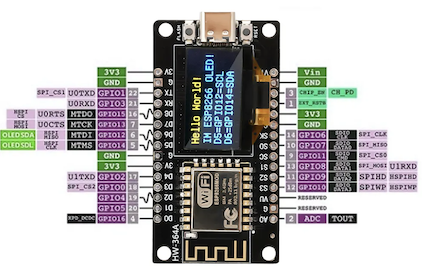
doc/nodemcu.png
