vbartusevicius/esp-measurement-platform/doc/oled-v1-portrait.png

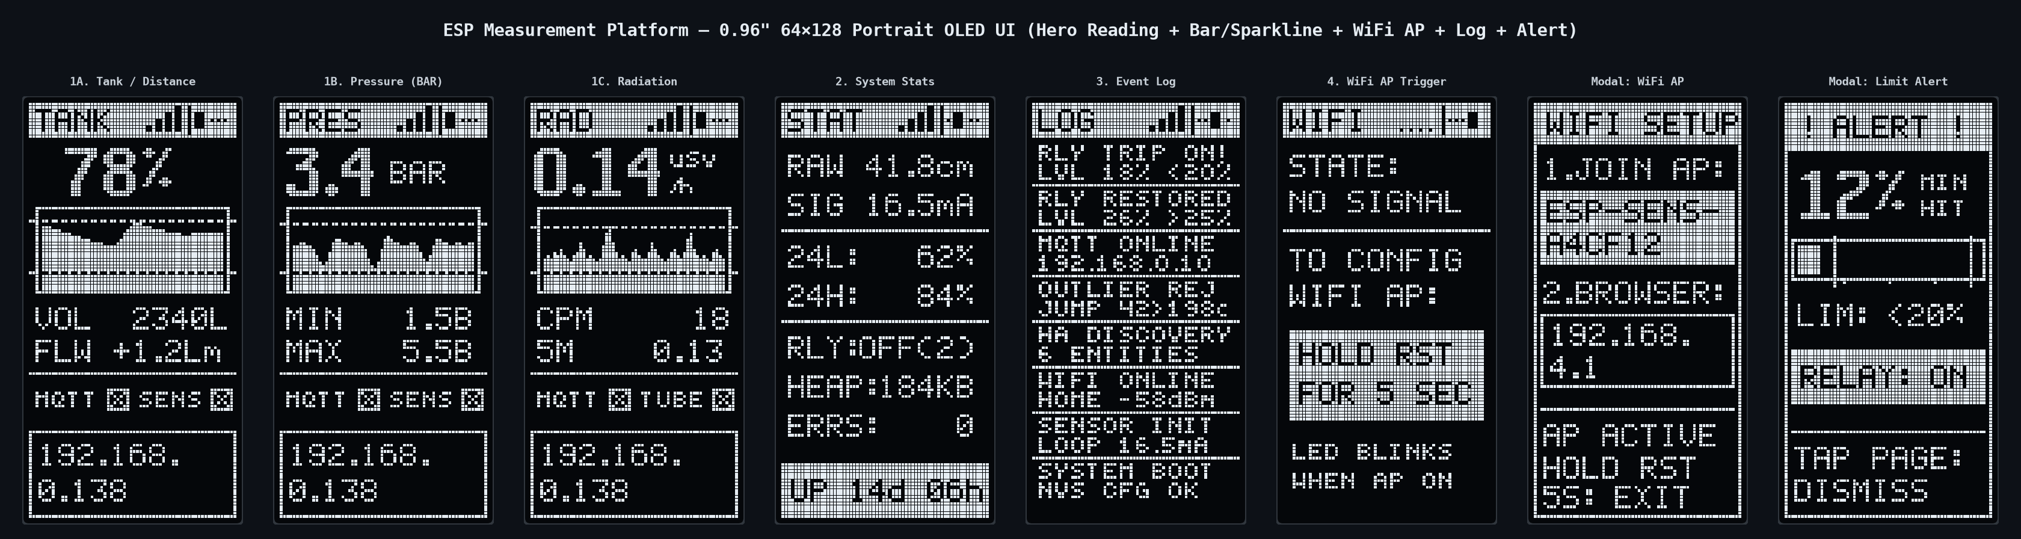
doc/oled-v1-portrait.png
