vbartusevicius/esp-measurement-platform/doc/radiation_oled_1.jpg

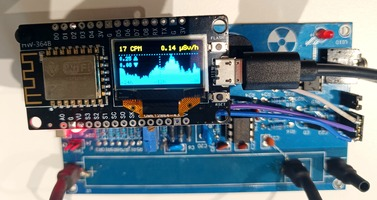
doc/radiation_oled_1.jpg
