vbartusevicius/esp-measurement-platform/doc/radiation_oled_2.jpg

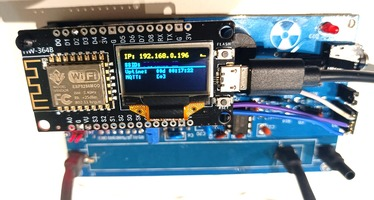
doc/radiation_oled_2.jpg
