vbartusevicius/esp-measurement-platform/doc/ultrasonic_sensor.png

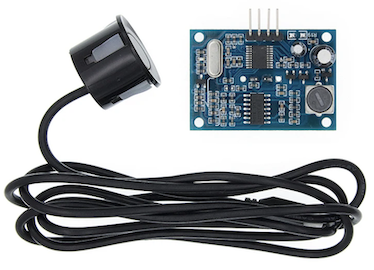
doc/ultrasonic_sensor.png
