vbartusevicius/esp-measurement-platform/hardware/releases/v1/accessories/dial_reader/renders/dial_reader_bottom.png

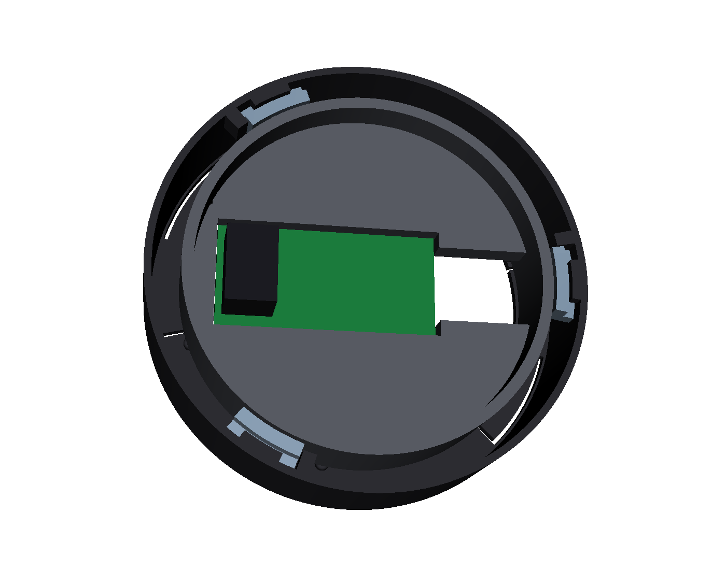
hardware/releases/v1/accessories/dial_reader/renders/dial_reader_bottom.png
