vbartusevicius/esp-measurement-platform/hardware/releases/v1/accessories/distance_sensor_pod/renders/distance_pod_bottom.png

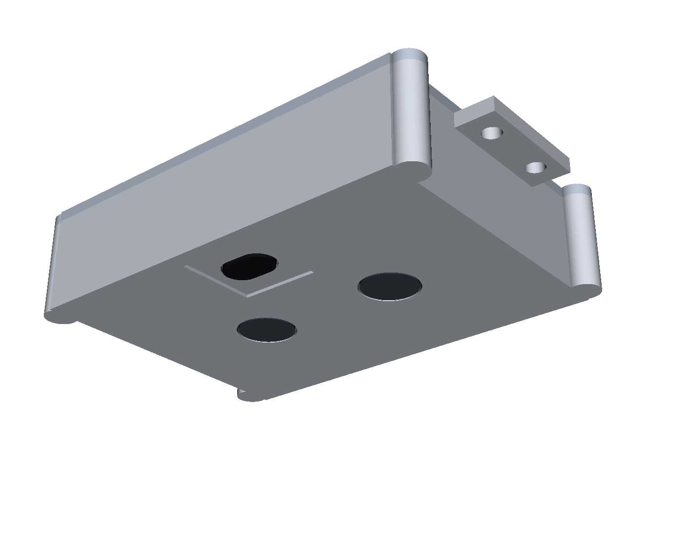
hardware/releases/v1/accessories/distance_sensor_pod/renders/distance_pod_bottom.png
