vbartusevicius/esp-measurement-platform/hardware/releases/v1/box_enclosure/renders/box_back.png

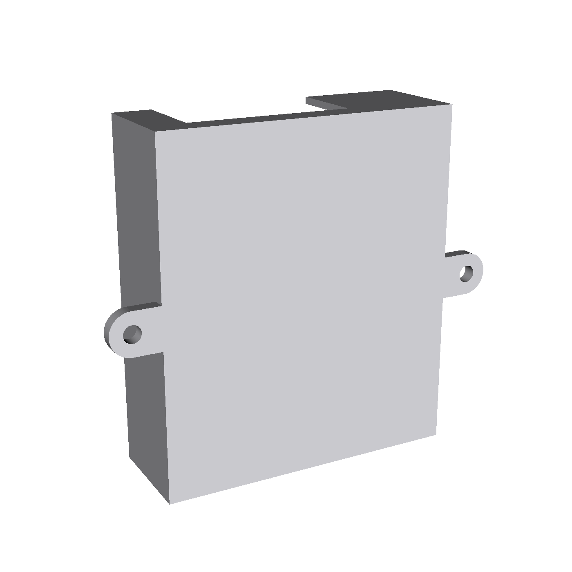
hardware/releases/v1/box_enclosure/renders/box_back.png
