vbartusevicius/esp-measurement-platform/hardware/releases/v1/box_enclosure/renders/box_inside.png

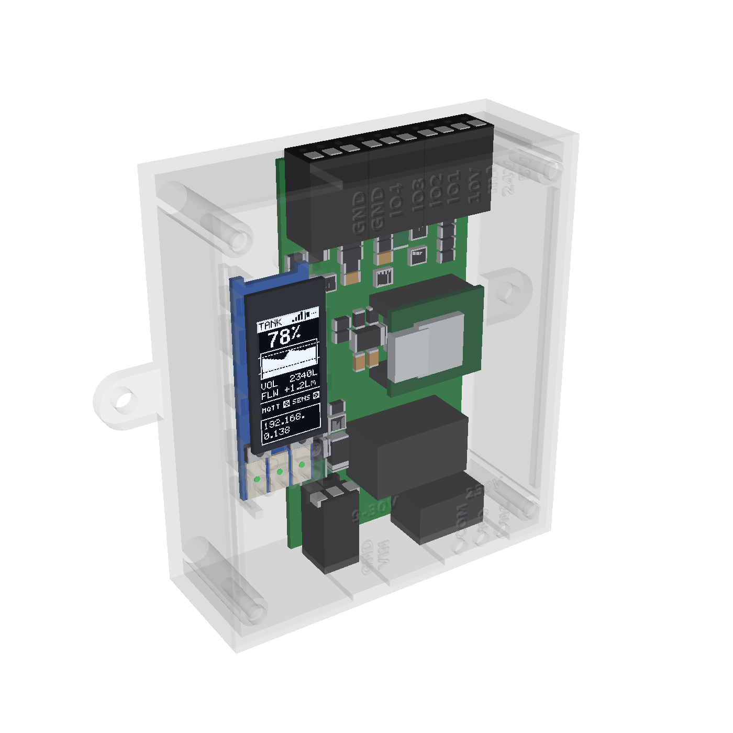
hardware/releases/v1/box_enclosure/renders/box_inside.png
