vbartusevicius/esp-measurement-platform/hardware/releases/v1/enclosure/renders/back.png

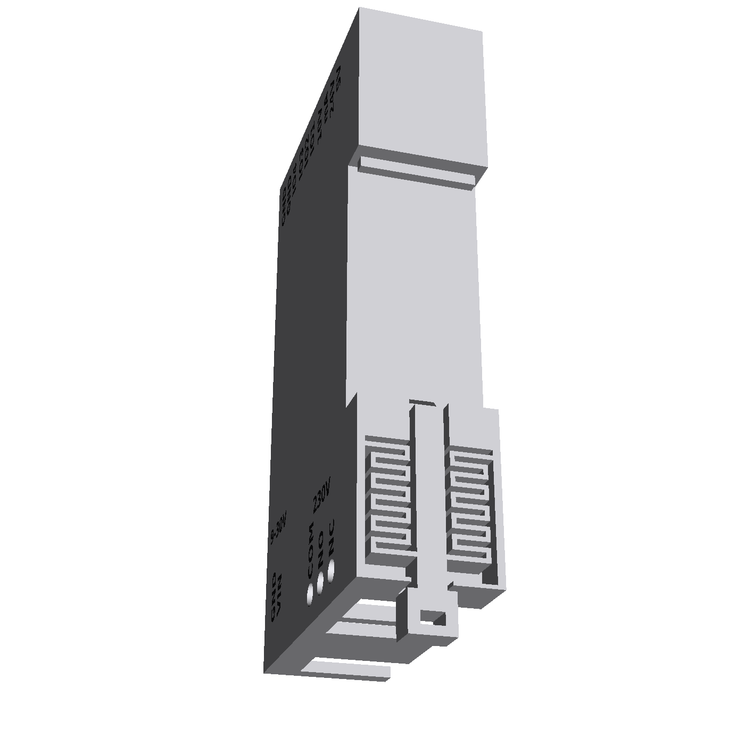
hardware/releases/v1/enclosure/renders/back.png
