vbartusevicius/esp-measurement-platform/hardware/releases/v1/assembly_parts.csv

Item | Qty | Part | Description | Source
MCU module (hand-fitted into sockets) | 1 | Seeed Studio XIAO ESP32C6 Pre-Soldered (SKU 102010636) | ESP32-C6 module with pre-soldered 2x7 pin headers; plugs into the two 5.0 mm female sockets (main U3) | Seeed Studio / Digi-Key / Mouser
XIAO sockets (hand-soldered) | 2 | Hong Cheng HC-PM254-5.0H-1x7PZ (LCSC C27985232): 1x7 2.54 mm female header, 5.0 mm tall | 1x7 female header, 2.54 mm, 5.0 mm tall, soldered into main U3; the XIAO stays detachable | LCSC
Power terminal (hand-soldered SMD, main J1) | 1 | WAGO 2086-1202/700-000/997-604 (2-pole 3.5 mm SMD push-in, push-button, 300 V / 10 A UL) | J1 GND / VIN+; JLCPCB has no stock (C3309855), so it is soldered by hand after assembly | Digi-Key / Newark / Mouser
OLED display (14-pin 0.62 mm solder FPC) | 1 | QG-6428TSWCG02 / JLX12864OLED-S096W / NFP1312-15AY (0.96 in 64x128 SSD1312 I2C) | 0.96 in 64x128 portrait SSD1312 I2C OLED (14.0 x 28.0 x 1.22 mm); 12.0 mm x 9.3 mm flex tail folds through the 9.8 mm top notch on UI and solders directly onto the 14-pad 0.62 mm pitch footprint ui J2 | AliExpress (1005003749452625) / Panelook / JLX
OLED backing foam | 2 | 3.0 mm closed-cell PE double-sided foam tape, 2 strips 1.4 x 26 mm (stacked on the 1.0 mm VHB pre-applied on NFP1312-15AY = 4.0 mm) | on the UI board front under the left/right back edges of the 14.0 x 28.0 mm OLED; compresses to 3.8 mm and presses the panel face into the cover's 1.0 mm pocket behind the window | any
Main-to-UI FFC cable | 1 | DEALON FC-0.5B-8P-50mm (LCSC C5242660; SHOU HAN C42416274 out of stock 2026-11-09) | 8-pin 0.5 mm reverse/opposite-side (Type B) FFC, 50 mm; main J3 <-> ui J1 | LCSC
Case base (snap-fit, no screws) | 1 | enclosure/base.stl | PETG or ASA, 0.2 mm layers, rail channel face down; slide the populated main board in from the open left side (terminal blocks enter the wall slots), clip THT solder tails to <= 2.5 mm | printed
Case cover (snap-fit, no screws) | 1 | enclosure/cover.stl | PETG or ASA, 0.2 mm layers, front face down; the two button bumps stand 0.6 mm proud, so enable supports from the build plate (or set BUTTON_TAB boss_height = 0 for a flat face); buttons are C-shaped spring tabs in the front wall with plungers (no separate parts); slides onto the base from the left | printed
