vbartusevicius/esp-measurement-platform/hardware/releases/v1/order_lcsc.csv

LCSC Part Number | Quantity | Manufacturer Part Number | Value | Footprint | Designators
C113965 | 1 | SMAJ30A | SMAJ30A | D_SMA | main:D1
C118758 | 1 | MF-USMF005-2 | 50mA | Fuse_1210_3225Metric | main:F2
C142747 | 1 | 1812L110/33MR | 1.1A | Fuse_1812_4532Metric | main:F1
C15850 | 3 | CL21A106KAYNNNE | 10u 25V | C_0805_2012Metric | main:C10,main:C11,reader:C1
C16015 | 2 | SS36 | SS36 | D_SMA | main:D2,main:D9
C167838 | 1 | FNR4020S220MT | 22uH | L_Sunlord_SWPA4020S | main:L1
C17414 | 8 | 0805W8F1002T5E | 10k | R_0805_2012Metric | main:R15,main:R4,main:R7,main:R9,reader:R3,ui:R1,ui:R3,ui:R5
C17513 | 1 | 0805W8F1001T5E | 1k | R_0805_2012Metric | reader:R5
C17557 | 1 | 0805W8F2200T5E | 220R | R_0805_2012Metric | reader:R1
C17560 | 1 | 0805W8F2202T5E | 22k | R_0805_2012Metric | main:R8
C17630 | 6 | 0805W8F3300T5E | 330R | R_0805_2012Metric | main:R11,main:R13,main:R19,main:R21,reader:R6,ui:R4
C17656 | 2 | 0805W8F3903T5E | 390k | R_0805_2012Metric | reader:R4,ui:R6
C17673 | 7 | 0805W8F4701T5E | 4k7 | R_0805_2012Metric | main:R10,main:R12,main:R16,main:R17,main:R18,main:R20,reader:R2
C17710 | 1 | 0805W8F4700T5E | 470R | R_0805_2012Metric | main:R14
C17756 | 1 | 0805W8F5602T5E | 56k | R_0805_2012Metric | main:R3
C17961 | 2 | 1206W4F2400T5E | 240R | R_1206_3216Metric | main:R5,main:R6
C20526 | 1 | MMBT3904(RANGE:100-300) | MMBT3904 | SOT-23 | main:Q1
C22371519 | 3 | WS2812B-MINI-V3J | WS2812B-MINI-V3J | LED_WS2812B-MINI-V3J | ui:D1,ui:D2,ui:D3
C231329 | 2 | B3U-1000P | B3U-1000P | SW_SPST_B3U-1000P | ui:SW1,ui:SW2
C236111 | 1 | MMSZ5V6T1G | 5V6 | D_SOD-123 | main:D8
C27985232 | 2 | Hong Cheng HC-PM254-5.0H-1x7PZ | XIAO sockets (hand-soldered) |  | off-board
C2856797 | 2 | FPC-05F-8PH20 | FPC-05F-8PH20 | FPC_Kinghelm_KH-FPC0.5-H1.2SMT-8P | main:J3,ui:J1
C2931912 | 1 | SCT2601TVBR | SCT2601TVBR | TSOT-23-6 | main:U1
C2984661 | 1 | TCRT5000 | TCRT5000 | Vishay_TCRT5000_Clips | reader:U1
C34731 | 1 | LMV331IDBVR | LMV331 | SOT-23-5 | reader:U2
C397217 | 1 | G6B-2114P-US DC5 | G6B-2114P-US DC5 | Relay_1A1B_Omron_G6B-2114P | main:K1
C4328 | 2 | 0805W8F2002T5E | 20k | R_0805_2012Metric | main:R2,ui:R2
C440198 | 2 | GRM21BR61H106KE43L | 10u 50V | C_0805_2012Metric | main:C2,main:C3
C45783 | 2 | CL21A226MAQNNNE | 22u 25V | C_0805_2012Metric | main:C5,main:C6
C47546 | 6 | BAT54S,215 | BAT54S | SOT-23 | main:D10,main:D11,main:D3,main:D4,main:D5,main:D6
C49678 | 14 | CC0805KRX7R9BB104 | 100n 50V | C_0805_2012Metric | main:C1,main:C4,main:C7,main:C8,main:C9,reader:C2,reader:C3,reader:C4,ui:C1,ui:C3,ui:C4,ui:C5,ui:C6,ui:C7
C5242660 | 1 | DEALON FC-0.5B-8P-50mm | Main-to-UI FFC cable |  | off-board
C64885 | 1 | B5819W | B5819W | D_SOD-123 | reader:D1
C699499 | 1 | DG127R-5.08-03P-14-00A(H) | DG127R-5.08-03P | TerminalBlock_Degson_DG127R-5.08-03P | main:J4
C719176 | 1 | TC33X-2-103E | 10k | Potentiometer_Bourns_TC33X_Vertical | reader:RV1
C7484 | 1 | SN74AHCT1G125DBVR | 74AHCT1G125 | SOT-23-5 | ui:U1
C84256 | 1 | NCD0805R1 | red | LED_0805_2012Metric | reader:D2
C8678 | 2 | SS34 | SS34 | D_SMA | main:D12,main:D7
C91185 | 5 | CC0805KKX7R9BB105 | 1u 50V | C_0805_2012Metric | ui:C10,ui:C11,ui:C2,ui:C8,ui:C9
C96346 | 1 | RC0805FR-07100KL | 100k | R_0805_2012Metric | main:R1
