vbartusevicius/esp-measurement-platform/hardware/releases/v1/order_mouser.csv

Mouser Part Number | Quantity | Part | Item
713-102010636 | 1 | Seeed Studio XIAO ESP32C6 Pre-Soldered (SKU 102010636) | MCU module (hand-fitted into sockets)
