vbartusevicius/esp-measurement-platform/hardware/releases/v1/main/main_bom.csv

Item | Qty | Designator | Value | Manufacturer | MPN | LCSC | Package | Type | Place | Description
1 | 1 | F2 | 50mA | Bourns | MF-USMF005-2 | C118758 | Fuse_1210_3225Metric | SMD | YES | 4-20 mA input PTC: 50 mA hold / 150 mA trip, 30 V
2 | 1 | Q1 | MMBT3904 | CJ | MMBT3904(RANGE:100-300) | C20526 | SOT-23 | SMD | YES | NPN relay coil driver (40 V, 200 mA, JLCPCB Basic Part; G6B 5 V coil draws 60 mA)
3 | 1 | L1 | 22uH | Changjiang Microelectronics | FNR4020S220MT | C167838 | L_Sunlord_SWPA4020S | SMD | YES | SCT2601 table 2: 22 uH for 5 V out; 1.1 A Isat, 0.87 A Irms, 455 mOhm, 4x4x2 mm shielded
4 | 1 | J4 | DG127R-5.08-03P | DEGSON | DG127R-5.08-03P-14-00A(H) | C699499 | TerminalBlock_Degson_DG127R-5.08-03P | THT | YES | Bottom-rear 3-pole 5.08 mm screw terminal (230 VAC relay output, IEC 250 V / 15 A): 1=COM, 2=NO, 3=NC; screws reached through the case's right side
5 | 1 | F1 | 1.1A | Littelfuse | 1812L110/33MR | C142747 | Fuse_1812_4532Metric | SMD | YES | 1.1 A hold / 2.2 A trip 33 V 1812 PTC resettable fuse on 24 V input
6 | 1 | D1 | SMAJ30A | MDD | SMAJ30A | C113965 | D_SMA | SMD | YES | 30 V stand-off / 48.4 V clamp unidirectional TVS after reverse diode
7 | 2 | D12,D7 | SS34 | MDD | SS34 | C8678 | D_SMA | SMD | YES | Relay coil flyback suppression diode
8 | 2 | D2,D9 | SS36 | MDD | SS36 | C16015 | D_SMA | SMD | YES | 60 V 3 A reverse-polarity blocking Schottky diode
9 | 2 | C2,C3 | 10u 50V | Murata | GRM21BR61H106KE43L | C440198 | C_0805_2012Metric | SMD | YES | SCT2601 24 V input decoupling
10 | 6 | D10,D11,D3,D4,D5,D6 | BAT54S | Nexperia | BAT54S,215 | C47546 | SOT-23 | SMD | YES | 4-20 mA ADC input clamp to GND and +3V3 (2 uA max at 25 V, 10 pF max)
11 | 1 | K1 | G6B-2114P-US DC5 | Omron | G6B-2114P-US DC5 | C397217 | Relay_1A1B_Omron_G6B-2114P | THT | YES | Omron G6B-2114P-US DC5 1a+1b power relay: 5 A 250 VAC, 3 kVAC / 6 kV coil-contacts (3+6 = COM, 4 = NO, 5 = NC)
12 | 1 | U1 | SCT2601TVBR | SCT | SCT2601TVBR | C2931912 | TSOT-23-6 | SMD | YES | SCT2601 datasheet: 4.5-60 V in (65 V abs max), 600 mA, 700 kHz, 80 ns min on-time
13 | 2 | C10,C11 | 10u 25V | Samsung | CL21A106KAYNNNE | C15850 | C_0805_2012Metric | SMD | YES | XIAO 5V input decoupling
14 | 2 | C5,C6 | 22u 25V | Samsung | CL21A226MAQNNNE | C45783 | C_0805_2012Metric | SMD | YES | SCT2601 5 V output decoupling
15 | 4 | R15,R4,R7,R9 | 10k | UNI-ROYAL | 0805W8F1002T5E | C17414 | R_0805_2012Metric | SMD | YES | SCT2601 FB bottom
16 | 1 | R2 | 20k | UNI-ROYAL | 0805W8F2002T5E | C4328 | R_0805_2012Metric | SMD | YES | SCT2601 EN UVLO bottom
17 | 1 | R8 | 22k | UNI-ROYAL | 0805W8F2202T5E | C17560 | R_0805_2012Metric | SMD | YES | 0-10V / 0-5V divider top (22k/10k -> 10 V = 3.125 V, 4.5 V = 1.406 V)
18 | 4 | R11,R13,R19,R21 | 330R | UNI-ROYAL | 0805W8F3300T5E | C17630 | R_0805_2012Metric | SMD | YES | IO1 series protection resistor
19 | 1 | R14 | 470R | UNI-ROYAL | 0805W8F4700T5E | C17710 | R_0805_2012Metric | SMD | YES | Relay NPN driver base resistor (5.4 mA for the 60 mA G6B coil)
20 | 6 | R10,R12,R16,R17,R18,R20 | 4k7 | UNI-ROYAL | 0805W8F4701T5E | C17673 | R_0805_2012Metric | SMD | YES | IO1 3.3 V pull-up (I2C / UART / pulses)
21 | 1 | R3 | 56k | UNI-ROYAL | 0805W8F5602T5E | C17756 | R_0805_2012Metric | SMD | YES | SCT2601 FB top: 5.05 V output
22 | 2 | R5,R6 | 240R | UNI-ROYAL | 1206W4F2400T5E | C17961 | R_1206_3216Metric | SMD | YES | 4-20 mA shunt half (240R || 240R = 120 ohm; 20 mA = 2.40 V)
23 | 2 | J5,J6 | 2086-1203/700-000/997-605 | WAGO | 2086-1203/700-000/997-605 | C3309626 | TerminalBlock_WAGO_2086-1203_SMD | SMD | YES | Top sensor bank poles 5..7: 1=IO1 (ECHO/SDA/RX), 2=IO2 (TRIG/SCL/TX), 3=IO3 (Geiger PULSE)
24 | 1 | J2 | 2086-1204/700-000/997-605 | WAGO | 2086-1204/700-000/997-605 | C3309718 | TerminalBlock_WAGO_2086-1204_SMD | SMD | YES | Top sensor bank poles 1..4 (3.5 mm SMD push-in, side entry): 1=+5V, 2=+24V, 3=4-20mA, 4=0-10V
25 | 1 | J3 | FPC-05F-8PH20 | XUNPU | FPC-05F-8PH20 | C2856797 | FPC_Kinghelm_KH-FPC0.5-H1.2SMT-8P | SMD | YES | 8-pin 0.5 mm FFC to the UI board J1
26 | 5 | C1,C4,C7,C8,C9 | 100n 50V | YAGEO | CC0805KRX7R9BB104 | C49678 | C_0805_2012Metric | SMD | YES | SCT2601 BST bootstrap cap
27 | 1 | R1 | 100k | YAGEO | RC0805FR-07100KL | C96346 | R_0805_2012Metric | SMD | YES | SCT2601 EN UVLO top
28 | 1 | D8 | 5V6 | onsemi | MMSZ5V6T1G | C236111 | D_SOD-123 | SMD | YES | Rail overvoltage Zener clamp
29 | 1 | U3 | XIAO ESP32C6 | Seeed Studio | 102010636 |  | XIAO_ESP32C6_Header | THT | NO | Hand-fitted after assembly: XIAO ESP32C6 Pre-Soldered on two 1x7 5.0 mm female socket strips
30 | 1 | J1 | 2086-1202/700-000/997-604 | WAGO | 2086-1202/700-000/997-604 |  | TerminalBlock_WAGO_2086-1202_SMD | SMD | NO | Hand-fitted after assembly: Bottom-front 2-pole 3.5 mm SMD push-in terminal (SELV): 1=GND, 2=VIN+ (9-30 V)
