vbartusevicius/esp-measurement-platform/hardware/releases/v1/ui/ui_bom.csv

Item | Qty | Designator | Value | Manufacturer | MPN | LCSC | Package | Type | Place | Description
1 | 2 | SW1,SW2 | B3U-1000P | Omron | B3U-1000P | C231329 | SW_SPST_B3U-1000P | SMD | YES | tap: reboot; hold 5 s: WiFi setup / factory reset
2 | 1 | U1 | 74AHCT1G125 | TI | SN74AHCT1G125DBVR | C7484 | SOT-23-5 | SMD | YES | TI SN74AHCT1G125 DBV: 1 OE, 2 A, 3 GND, 4 Y, 5 VCC
3 | 3 | R1,R3,R5 | 10k | UNI-ROYAL | 0805W8F1002T5E | C17414 | R_0805_2012Metric | SMD | YES | Ladder pull-up; no-button = 3V3
4 | 1 | R2 | 20k | UNI-ROYAL | 0805W8F2002T5E | C4328 | R_0805_2012Metric | SMD | YES | RST/WIFI ladder: 3V3*20k/30k=2.2V
5 | 1 | R4 | 330R | UNI-ROYAL | 0805W8F3300T5E | C17630 | R_0805_2012Metric | SMD | YES | WS2812B datasheet: series resistor at DIN
6 | 1 | R6 | 390k | UNI-ROYAL | 0805W8F3903T5E | C17656 | R_0805_2012Metric | SMD | YES | SSD1312 IREF segment current reference (390k to GND)
7 | 3 | D1,D2,D3 | WS2812B-MINI-V3J | Worldsemi | WS2812B-MINI-V3J | C22371519 | LED_WS2812B-MINI-V3J | SMD | YES | WS2812B-MINI-V3J RGB LED with gull-wing legs, hand-solderable (STATUS)
8 | 1 | J1 | FPC-05F-8PH20 | XUNPU | FPC-05F-8PH20 | C2856797 | FPC_Kinghelm_KH-FPC0.5-H1.2SMT-8P | SMD | YES | 8-pin 0.5 mm FFC to main J3
9 | 5 | C10,C11,C2,C8,C9 | 1u 50V | YAGEO | CC0805KKX7R9BB105 | C91185 | C_0805_2012Metric | SMD | YES | 5 V entry from the FFC cable
10 | 6 | C1,C3,C4,C5,C6,C7 | 100n 50V | YAGEO | CC0805KRX7R9BB104 | C49678 | C_0805_2012Metric | SMD | YES | Ladder debounce/filter cap
11 | 1 | J2 | OLED | Allvision / JLX | QG-6428TSWCG02 |  | OLED_FPC_14P_P0.62mm_Hotbar | SMD | NO | Hand-fitted after assembly: 14-pin 0.62 mm pitch (P0.62x13=8.06 mm, 12.0 mm tail, 9.3 mm wide) soldering FPC footprint on the back of the UI board receiving the folded flex tail of the 0.96in 64x128 SSD1312 portrait I2C OLED (QG-6428TSWCG02 / JLX12864OLED-S096W / NFP1312-15AY, 14.0x28.0x1.22 mm)
