vbartusevicius/esp-measurement-platform/hardware/releases/v1/accessories/dial_reader/dial_reader_assembly.step

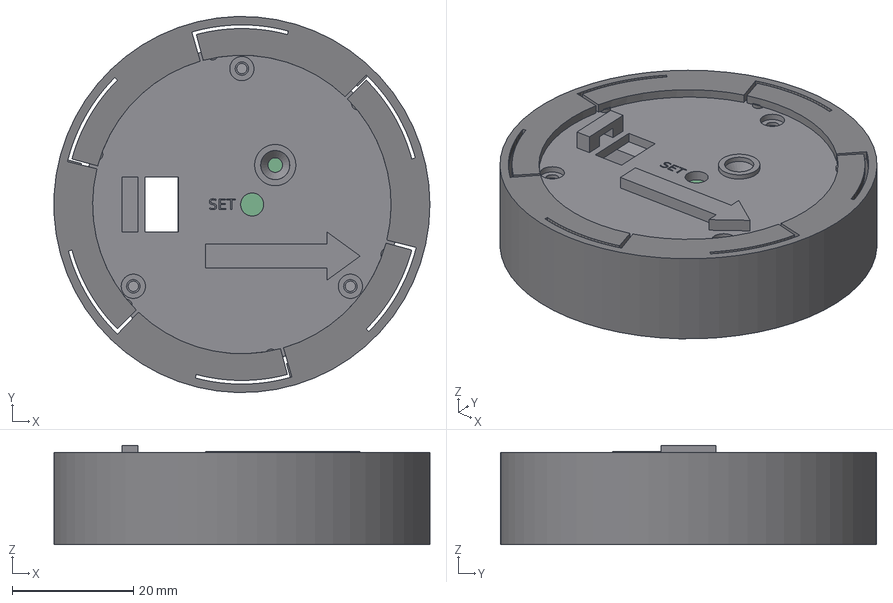
[picture p43: CAD file, 2026-11-11]
hardware/releases/v1/accessories/dial_reader/dial_reader_assembly.step
62.0 x 62.0 x 16.4 mm
dial_reader_ring
dial_reader_carrier
dial_reader_lid
pcb
dial_hook_0
dial_hook_1
dial_hook_2
