vbartusevicius/esp-measurement-platform/hardware/releases/v1/accessories/radiation_duct/radiation_duct_assembly.step

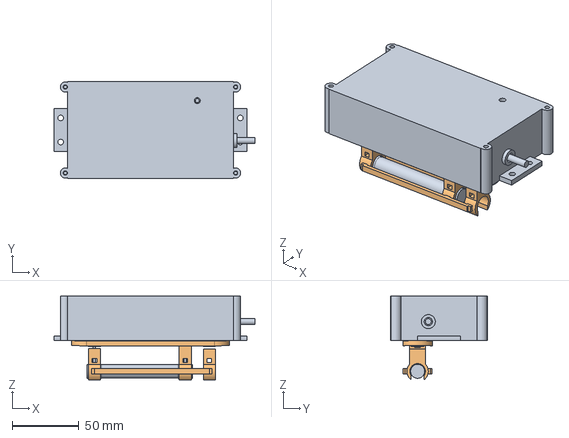
[picture p44: CAD file, 2026-11-11]
hardware/releases/v1/accessories/radiation_duct/radiation_duct_assembly.step
150.4 x 72.4 x 62.5 mm
