vbartusevicius/esp-measurement-platform/hardware/releases/v1/main/main.step

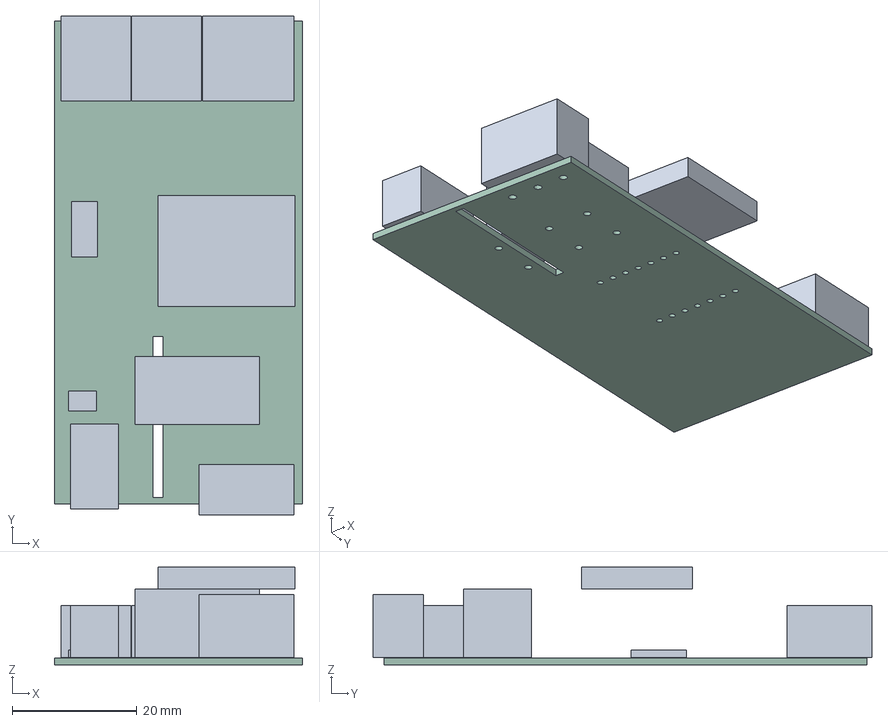
[picture p45: CAD file, 2026-11-11]
hardware/releases/v1/main/main.step
39.8 x 80.0 x 15.7 mm
main_PCB
