vbartusevicius/esp-measurement-platform/hardware/releases/v1/box_enclosure/box_assembly.step

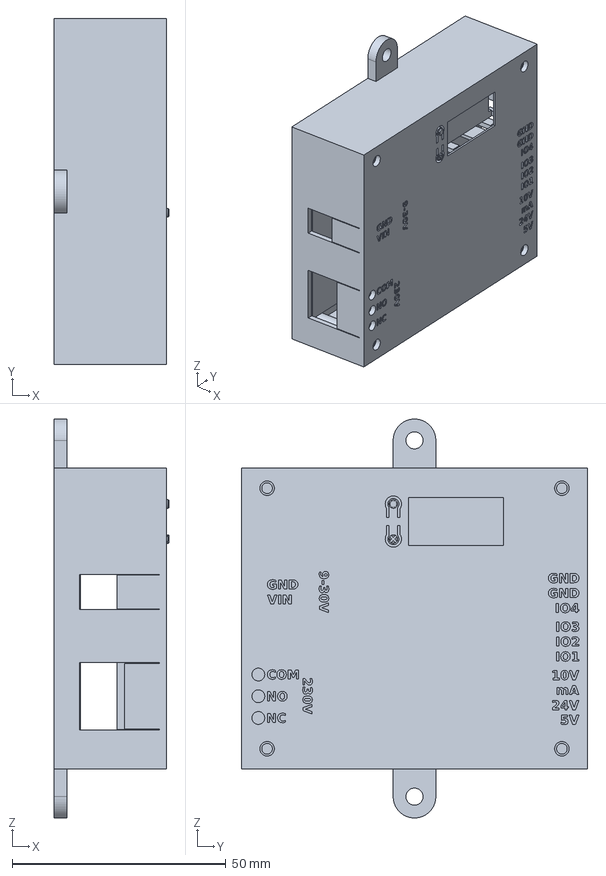
[picture p46: CAD file, 2026-11-11]
hardware/releases/v1/box_enclosure/box_assembly.step
26.9 x 81.0 x 93.4 mm
