vbartusevicius/esp-measurement-platform/hardware/releases/v1/enclosure/assembly.step

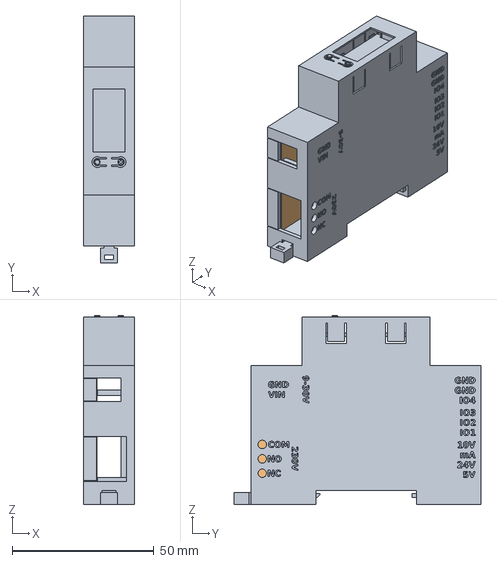
[picture p47: CAD file, 2026-11-11]
hardware/releases/v1/enclosure/assembly.step
18.0 x 87.0 x 66.6 mm
