vbartusevicius/esp-measurement-platform/hardware/releases/v1/accessories/distance_sensor_pod/distance_pod_assembly.step

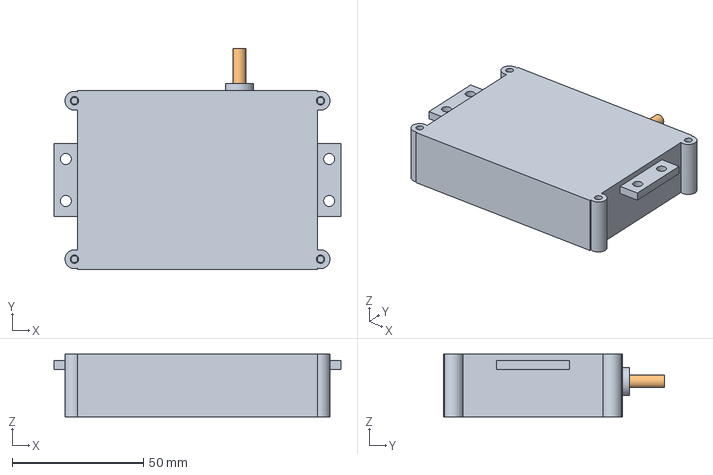
[picture p48: CAD file, 2026-11-11]
hardware/releases/v1/accessories/distance_sensor_pod/distance_pod_assembly.step
109.4 x 84.4 x 23.9 mm
