vbartusevicius/esp-measurement-platform/hardware/releases/v1/accessories/distance_sensor_pod/distance_pod_cover.step

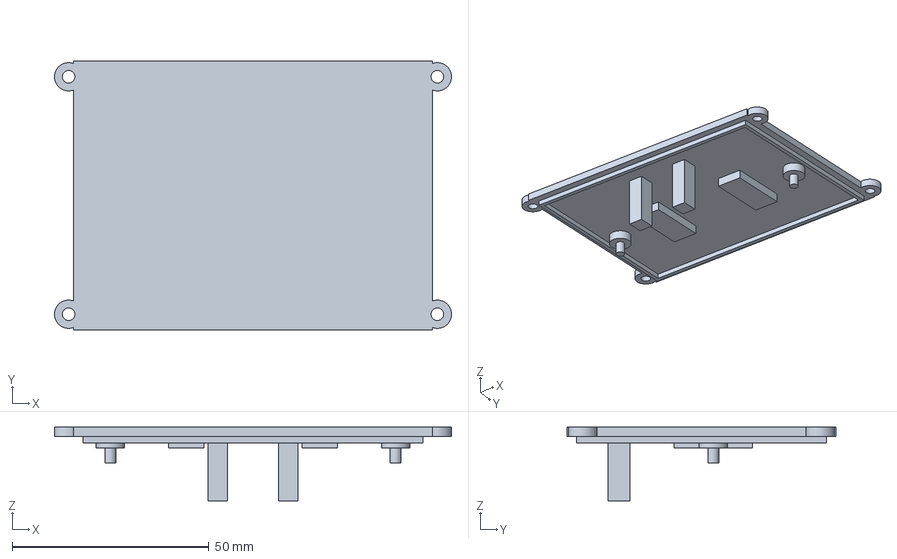
[picture p49: CAD file, 2026-11-11]
hardware/releases/v1/accessories/distance_sensor_pod/distance_pod_cover.step
101.0 x 68.4 x 18.8 mm
