vbartusevicius/esp-measurement-platform/hardware/releases/v1/box_enclosure/box_lid.step

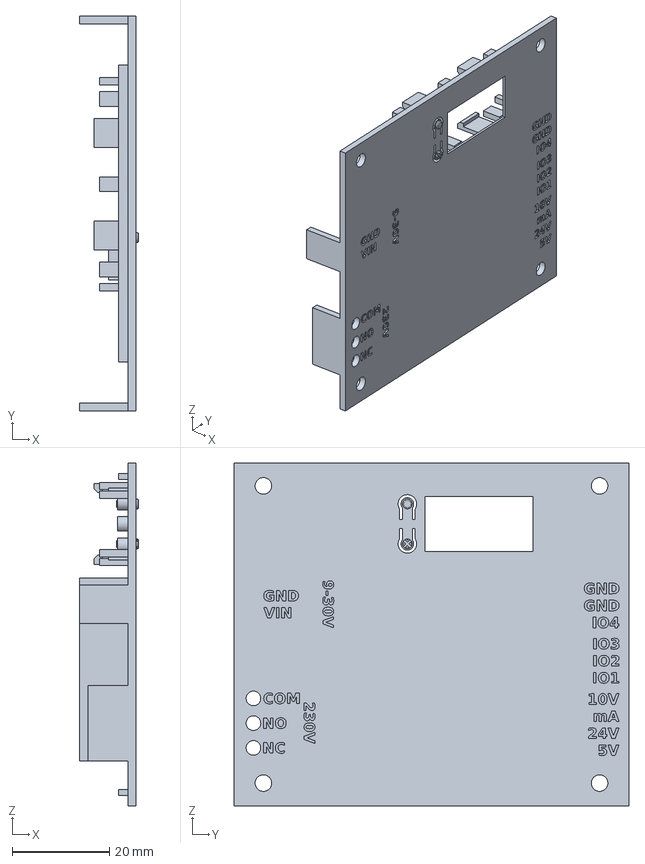
[picture p50: CAD file, 2026-11-11]
hardware/releases/v1/box_enclosure/box_lid.step
12.2 x 81.0 x 70.4 mm
