vbartusevicius/esp-measurement-platform/hardware/releases/v1/enclosure/cover.step

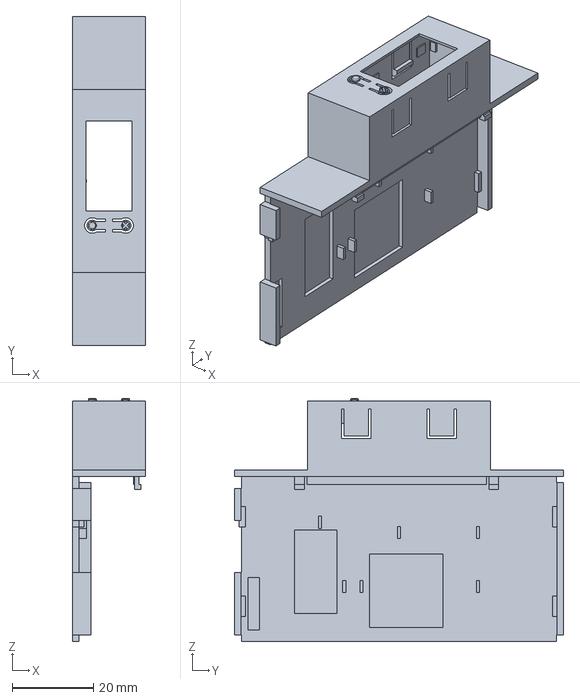
[picture p51: CAD file, 2026-11-11]
hardware/releases/v1/enclosure/cover.step
18.0 x 81.0 x 59.8 mm
