vbartusevicius/esp-measurement-platform/hardware/releases/v1/reader/reader.step

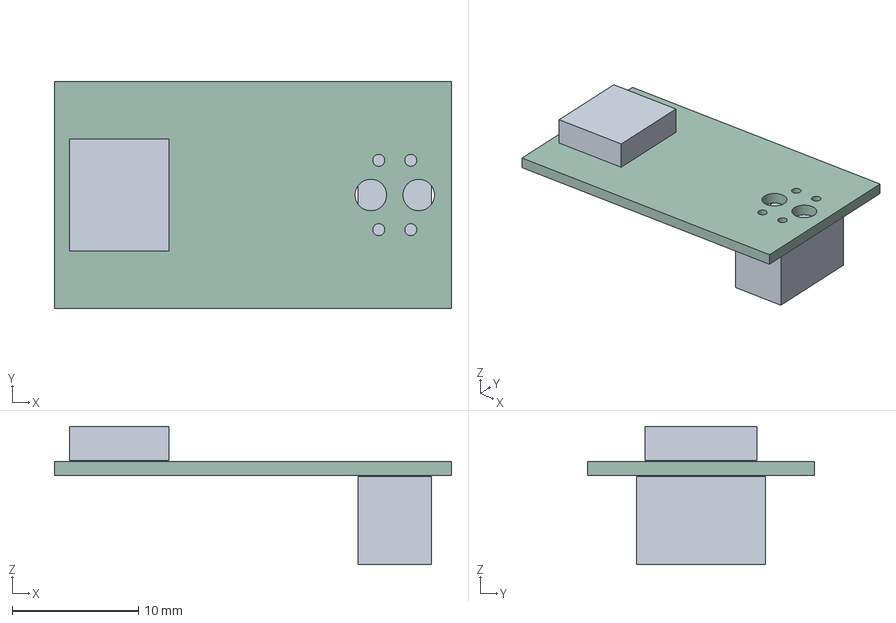
[picture p52: CAD file, 2026-11-11]
hardware/releases/v1/reader/reader.step
31.5 x 18.0 x 11.0 mm
reader_PCB
