vbartusevicius/esp-measurement-platform/hardware/releases/v1/ui/ui.step

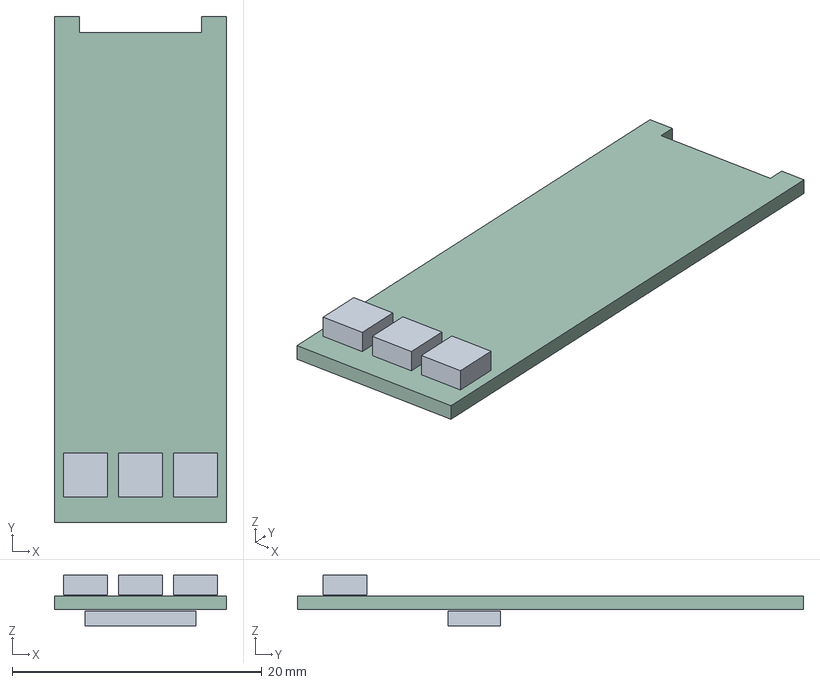
[picture p53: CAD file, 2026-11-11]
hardware/releases/v1/ui/ui.step
13.8 x 40.5 x 4.05 mm
ui_PCB
