vbartusevicius/esp-measurement-platform/hardware/releases/v1/accessories/dial_reader/dial_reader_carrier.step

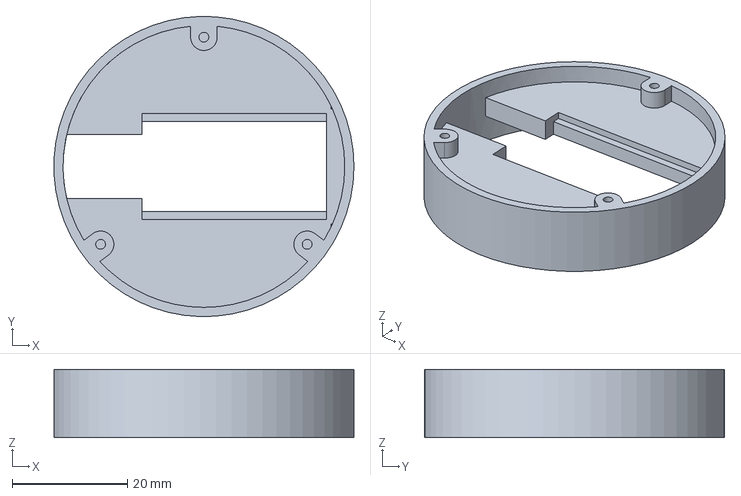
[picture p54: CAD file, 2026-11-11]
hardware/releases/v1/accessories/dial_reader/dial_reader_carrier.step
52.0 x 52.0 x 11.8 mm
