vbartusevicius/esp-measurement-platform/hardware/releases/v1/accessories/distance_sensor_pod/distance_pod_base.step

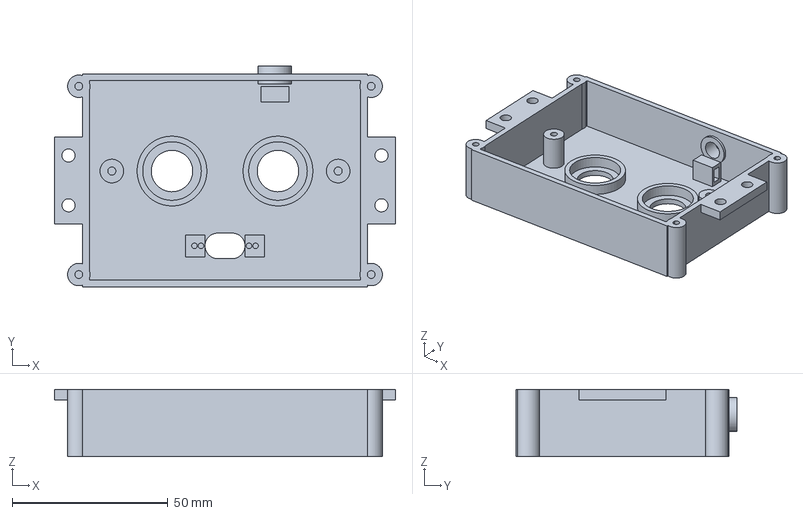
[picture p55: CAD file, 2026-11-11]
hardware/releases/v1/accessories/distance_sensor_pod/distance_pod_base.step
109.4 x 70.9 x 21.5 mm
