vbartusevicius/esp-measurement-platform/hardware/releases/v1/accessories/radiation_duct/cajoe_box_cover.step

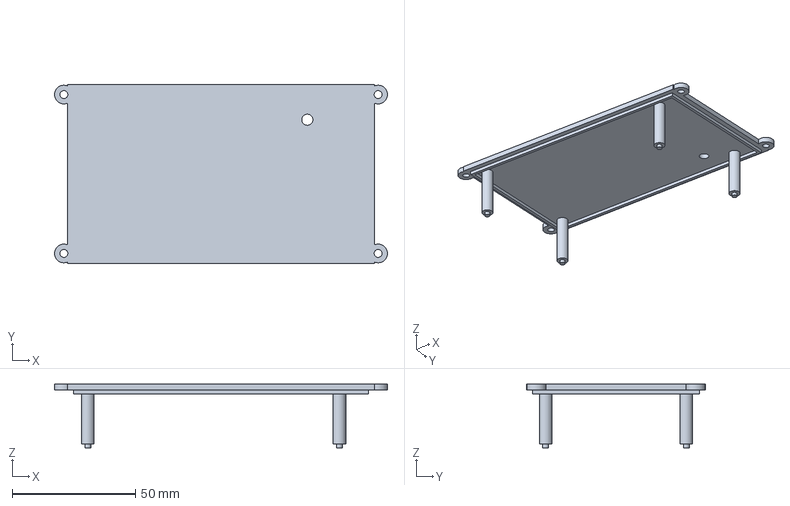
[picture p56: CAD file, 2026-11-11]
hardware/releases/v1/accessories/radiation_duct/cajoe_box_cover.step
135.0 x 72.4 x 25.8 mm
