vbartusevicius/esp-measurement-platform/hardware/releases/v1/accessories/dial_reader/dial_reader_lid.step

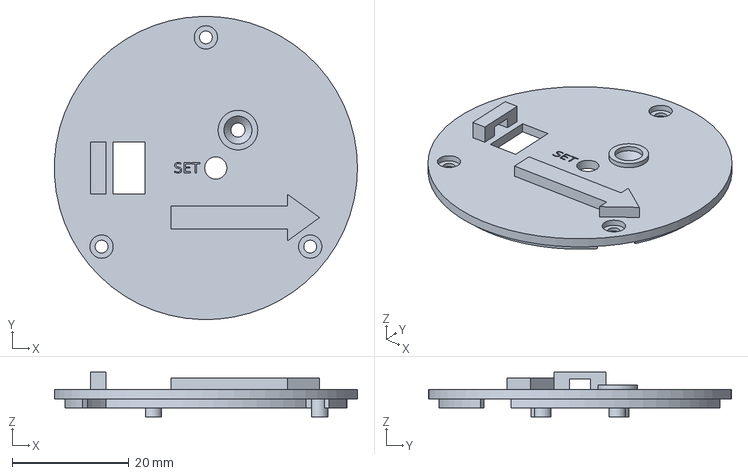
[picture p57: CAD file, 2026-11-11]
hardware/releases/v1/accessories/dial_reader/dial_reader_lid.step
52.0 x 52.0 x 7.65 mm
