vbartusevicius/esp-measurement-platform/hardware/releases/v1/accessories/radiation_duct/cajoe_box_base.step

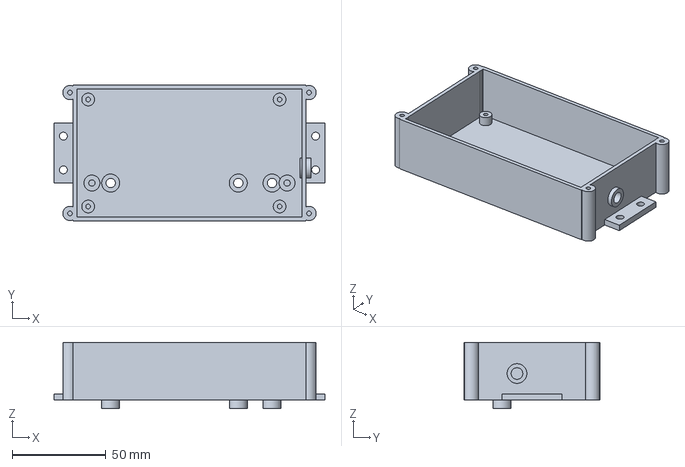
[picture p58: CAD file, 2026-11-11]
hardware/releases/v1/accessories/radiation_duct/cajoe_box_base.step
144.4 x 72.4 x 35.3 mm
