vbartusevicius/esp-measurement-platform/hardware/releases/v1/box_enclosure/box_base.step

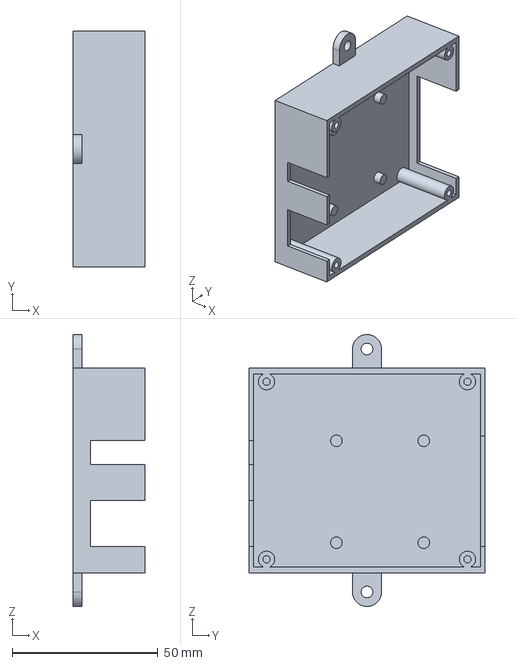
[picture p59: CAD file, 2026-11-11]
hardware/releases/v1/box_enclosure/box_base.step
24.7 x 81.0 x 93.4 mm
