vbartusevicius/esp-measurement-platform/hardware/releases/v1/enclosure/base.step

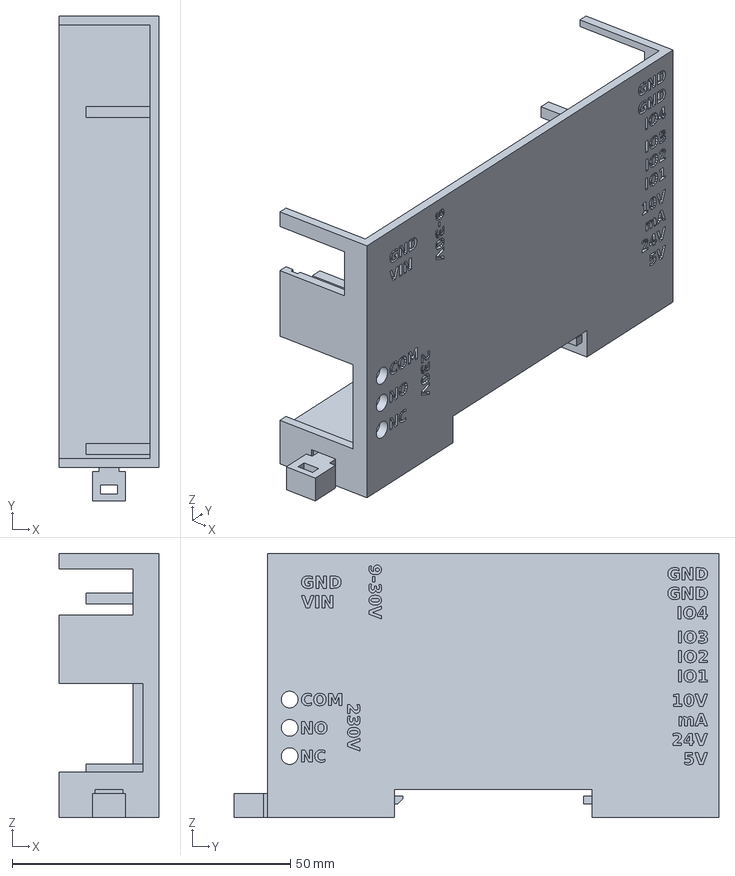
[picture p60: CAD file, 2026-11-11]
hardware/releases/v1/enclosure/base.step
18.0 x 87.0 x 47.4 mm
