vbartusevicius/esp-measurement-platform/hardware/releases/v1/accessories/dial_reader/dial_reader_test_ring.step

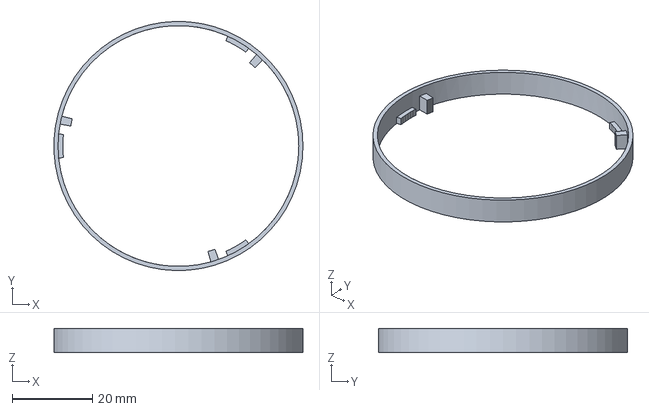
[picture p61: CAD file, 2026-11-11]
hardware/releases/v1/accessories/dial_reader/dial_reader_test_ring.step
62.0 x 62.0 x 6.00 mm
