vbartusevicius/esp-measurement-platform/hardware/releases/v1/accessories/radiation_duct/duct_tube_bracket.step

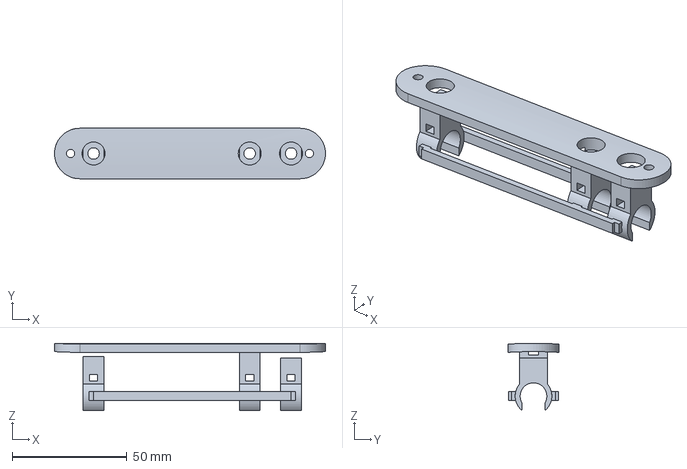
[picture p62: CAD file, 2026-11-11]
hardware/releases/v1/accessories/radiation_duct/duct_tube_bracket.step
118.0 x 22.0 x 29.3 mm
