vbartusevicius/esp-measurement-platform/hardware/releases/v1/accessories/dial_reader/dial_reader_ring.step

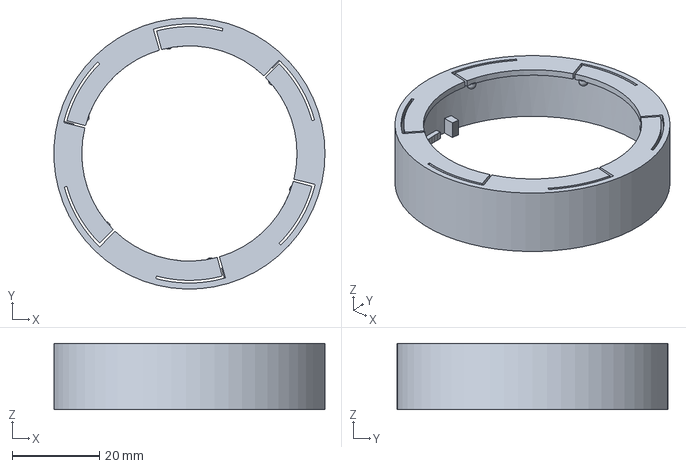
[picture p63: CAD file, 2026-11-11]
hardware/releases/v1/accessories/dial_reader/dial_reader_ring.step
62.0 x 62.0 x 15.2 mm
