vbartusevicius/esp-measurement-platform/(list of files, cad)

Other CAD files:
hardware/releases/v1/enclosure/cover_embossed.step
hardware/releases/v1/enclosure/cover_color.3mf
hardware/releases/v1/accessories/dial_reader/dial_reader_carrier.stl
hardware/releases/v1/accessories/dial_reader/dial_reader_lid.stl
hardware/releases/v1/accessories/dial_reader/dial_reader_ring.stl
hardware/releases/v1/accessories/dial_reader/dial_reader_test_ring.stl
hardware/releases/v1/accessories/distance_sensor_pod/distance_pod_base.stl
hardware/releases/v1/accessories/distance_sensor_pod/distance_pod_cover.stl
hardware/releases/v1/accessories/radiation_duct/cajoe_box_base.stl
hardware/releases/v1/accessories/radiation_duct/cajoe_box_cover.stl
hardware/releases/v1/accessories/radiation_duct/duct_tube_bracket.stl
hardware/releases/v1/box_enclosure/box_base.stl
hardware/releases/v1/box_enclosure/box_lid.stl
hardware/releases/v1/enclosure/base.stl
hardware/releases/v1/enclosure/cover.stl
hardware/releases/v1/enclosure/cover_embossed.stl
