vbartusevicius/esp-measurement-platform/doc/analog_result.jpg

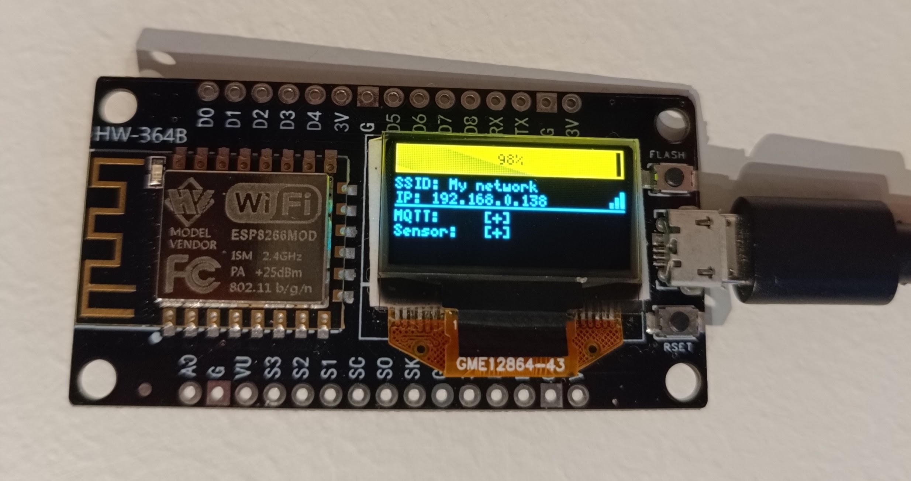
doc/analog_result.jpg
