vbartusevicius/esp-measurement-platform/hardware/releases/v1/panel/panel.kicad_pcb

## KiCad design hardware/releases/v1/panel/panel.kicad_pcb (2026-11-11)

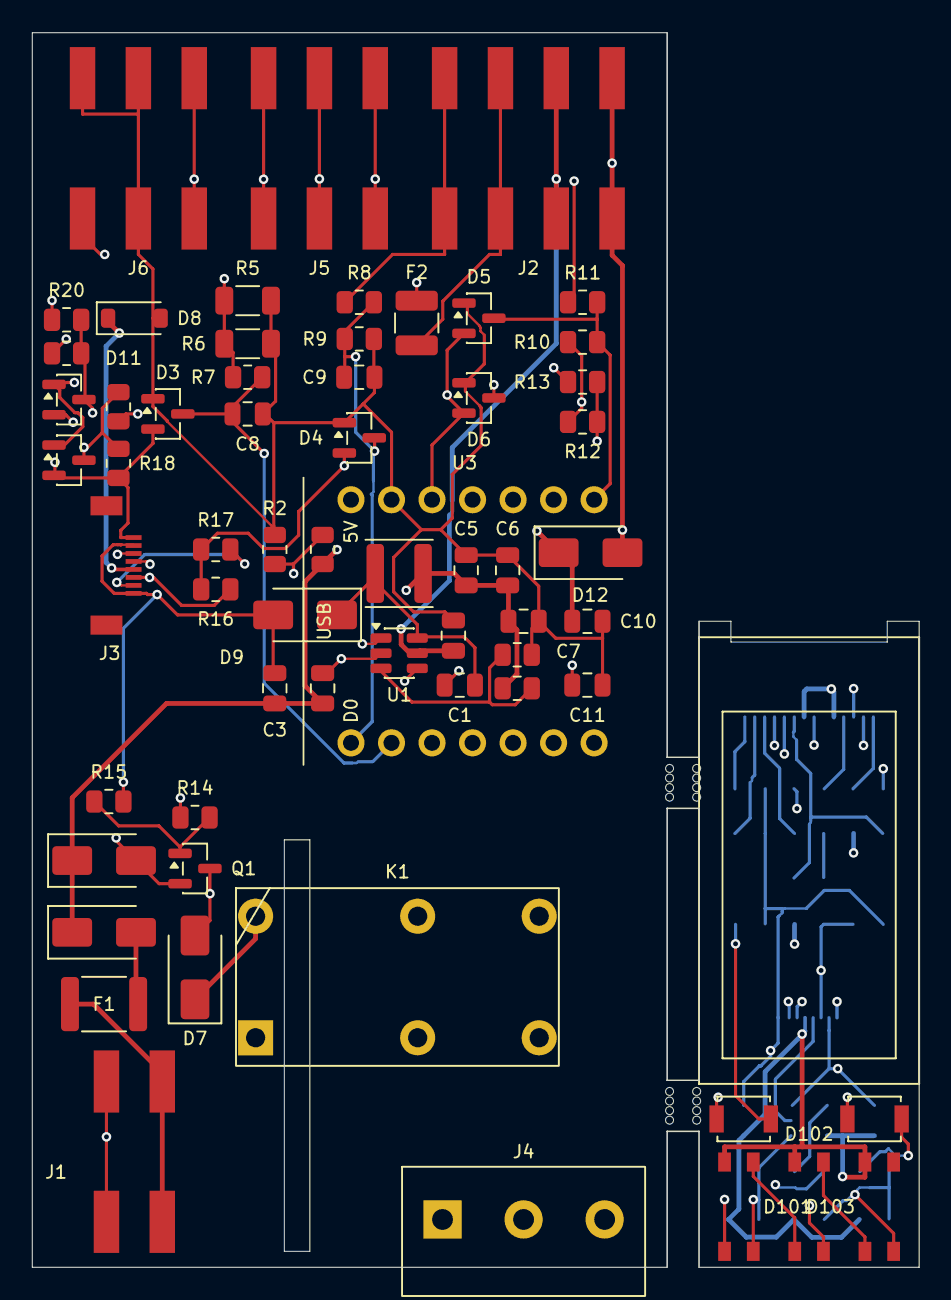
[picture p69: board panel.kicad_pcb from above]

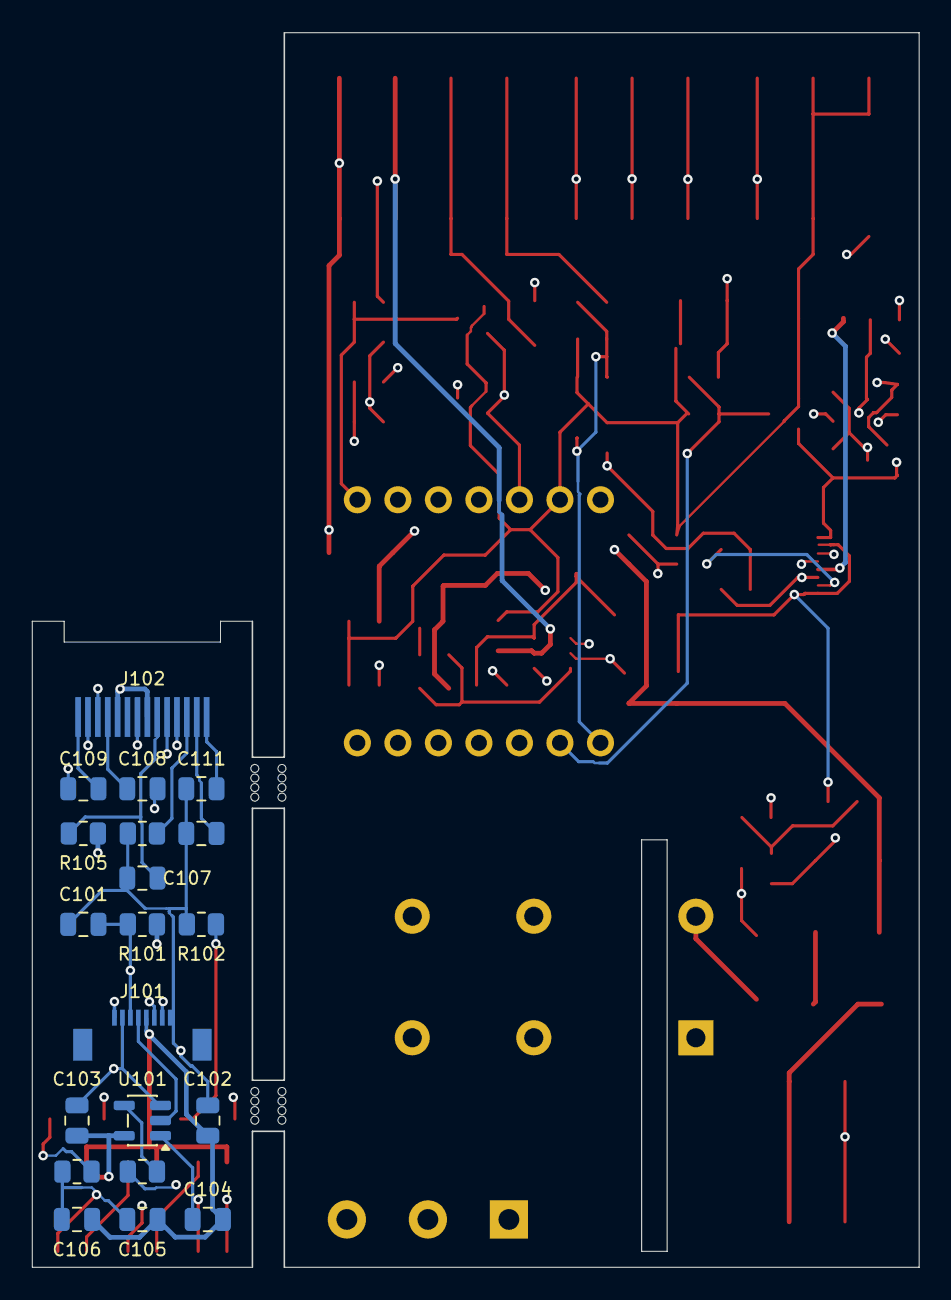
[picture p70: board panel.kicad_pcb from below]

Board: 4 copper layers, 55.6 x 77.4 mm, 83 parts (20 on the bottom side), 55 nets.

Parts:
C1, C4, C7, C8, C9, C101, C103, C104, C105, C106, C107: 100n 50V; C_0805_2012Metric
C2, C3: 10u 50V; C_0805_2012Metric
C5, C6: 22u 25V; C_0805_2012Metric
C10, C11: 10u 25V; C_0805_2012Metric
C102, C108, C109, C110, C111: 1u 50V; C_0805_2012Metric
D1: SMAJ30A; D_SMA
D2, D9: SS36; D_SMA
D3, D4, D5, D6, D10, D11: BAT54S; SOT-23
D7, D12: SS34; D_SMA
D8: 5V6; D_SOD-123
D101, D102, D103: WS2812B-MINI-V3J; LED_WS2812B-MINI-V3J
F1: 1.1A; Fuse_1812_4532Metric
F2: 50mA; Fuse_1210_3225Metric
J1: 2086-1202/700-000/997-604; TerminalBlock_WAGO_2086-1202_SMD
J2: 2086-1204/700-000/997-605; TerminalBlock_WAGO_2086-1204_SMD
J3, J101: FPC-05F-8PH20; FPC_Kinghelm_KH-FPC0.5-H1.2SMT-8P
J4: DG127R-5.08-03P; TerminalBlock_Degson_DG127R-5.08-03P
J5, J6: 2086-1203/700-000/997-605; TerminalBlock_WAGO_2086-1203_SMD
J102: OLED; OLED_FPC_14P_P0.62mm_Hotbar
K1: G6B-2114P-US DC5; Relay_1A1B_Omron_G6B-2114P
L1: 22uH; L_Sunlord_SWPA4020S
MOUSE_BITES: DNP
Q1: MMBT3904; SOT-23
R1: 100k; R_0805_2012Metric
R2, R102: 20k; R_0805_2012Metric
R3: 56k; R_0805_2012Metric
R4, R7, R9, R15, R101, R103, R105: 10k; R_0805_2012Metric
R5, R6: 240R; R_1206_3216Metric
R8: 22k; R_0805_2012Metric
R10, R12, R16, R17, R18, R20: 4k7; R_0805_2012Metric
R11, R13, R19, R21, R104: 330R; R_0805_2012Metric
R14: 470R; R_0805_2012Metric
R106: 390k; R_0805_2012Metric
SW101, SW102: B3U-1000P; SW_SPST_B3U-1000P
U1: SCT2601TVBR; TSOT-23-6
U3: XIAO ESP32C6; XIAO_ESP32C6_Header
U101: 74AHCT1G125; SOT-23-5

Connections:
+3V3: C11.1, D3.2, D4.2, D5.2, D6.2, D10.2, D11.2, J3.1, R10.1, R12.1, R16.1, R17.1, R18.1, R20.1, U3.12
+5V: C5.1, C6.1, C7.1, D7.1, D8.1, D12.2, J2.1, J3.5, K1.8, L1.2, R3.1
+5V_XIAO: C10.1, D12.1, U3.14
+24V_LOOP: C2.1, C3.1, C4.1, D1.1, D2.1, J2.2, R1.1, U1.5
BTN_LADDER: J3.3, U3.3
BUCK5_SW: C1.2, D9.1, L1.1, U1.6
GND: C2.2, C3.2, C4.2, C5.2, C6.2, C7.2, C8.2, C9.2, C10.2, C11.2, D1.2, D3.1, D4.1, D5.1, D6.1, D8.2, D9.2, D10.1, D11.1, J1.1, J3.2, J3.8, J6.2, J6.3, Q1.2, R2.2, R4.2, R5.2, R6.2, R9.2, R15.2, U1.2, U3.13
I2C_SCL: J3.7, R17.2, U3.6
I2C_SDA: J3.6, R16.2, U3.5
IO1_MCU: D5.3, R10.2, R11.2, U3.8
IO1_TERM: J5.1, R11.1
IO2_MCU: D6.3, R12.2, R13.2, U3.7
IO2_TERM: J5.2, R13.1
IO3_MCU: D10.3, R18.2, R19.2, U3.10
IO3_TERM: J5.3, R19.1
IO4_MCU: D11.3, R20.2, R21.2, U3.11
IO4_TERM: J6.1, R21.1
LED_DATA: J3.4, U3.4
MA_MCU: C8.1, D3.3, R7.2, U3.2
MA_SHUNT: F2.2, R5.1, R6.1, R7.1
MA_TERM: F2.1, J2.3
unnamed: R1.2, R2.1, U1.4
unnamed: C1.1, U1.1
unnamed: R3.2, R4.1, U1.3
RELAY_BASE: Q1.1, R14.2, R15.1
RELAY_COIL_N: D7.2, K1.1, Q1.3
RELAY_COM: J4.1, K1.3, K1.6
RELAY_MCU: R14.1, U3.9
RELAY_NC: J4.3, K1.5
RELAY_NO: J4.2, K1.4
UI_+3V3: J101.1, J102.5, J102.8, R101.1, R105.1
UI_+5V: C102.1, C103.1, C104.1, C105.1, C106.1, D101.1, D102.1, D103.1, J101.5, U101.5
UI_BTN_LADDER: C101.1, J101.3, R101.2, SW101.1, SW102.1
UI_GND: C101.2, C102.2, C103.2, C104.2, C105.2, C106.2, C107.2, C110.2, C111.2, D101.3, D102.3, D103.3, J101.2, J101.8, J102.7, R102.2, R103.2, R106.2, U101.1, U101.3
UI_I2C_SCL: J101.7, J102.10
UI_I2C_SDA: J101.6, J102.11
UI_LED_CHAIN1: D101.2, D102.4
UI_LED_CHAIN2: D102.2, D103.4
UI_LED_DATA: J101.4, U101.2
UI_N$1: R102.1, SW101.2
UI_N$2: R103.1, SW102.2
UI_N$3: R104.1, U101.4
UI_N$4: D101.4, R104.2
UI_OLED_C1N: C108.2, J102.4
UI_OLED_C1P: C108.1, J102.3
UI_OLED_C2N: C109.2, J102.2
UI_OLED_C2P: C109.1, J102.1
UI_OLED_IREF: J102.12, R106.1
UI_OLED_RES: C107.1, J102.9, R105.2
UI_OLED_VCOMH: C110.1, J102.13
UI_OLED_VOUT: C111.1, J102.14
V0_10_MCU: C9.1, D4.3, R8.2, R9.1, U3.1
V0_10_TERM: J2.4, R8.1
VIN_FUSED: D2.2, F1.2
VIN_RAW: F1.1, J1.2
