vbartusevicius/esp-measurement-platform/hardware/releases/v1/ui/ui.kicad_pcb

## KiCad design hardware/releases/v1/ui/ui.kicad_pcb (2026-11-11)

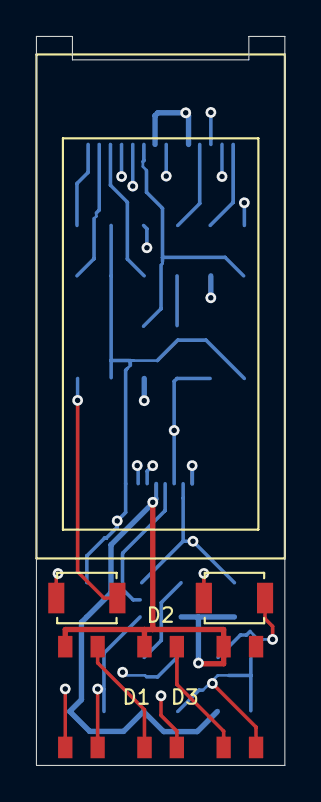
[picture p71: board ui.kicad_pcb from above]

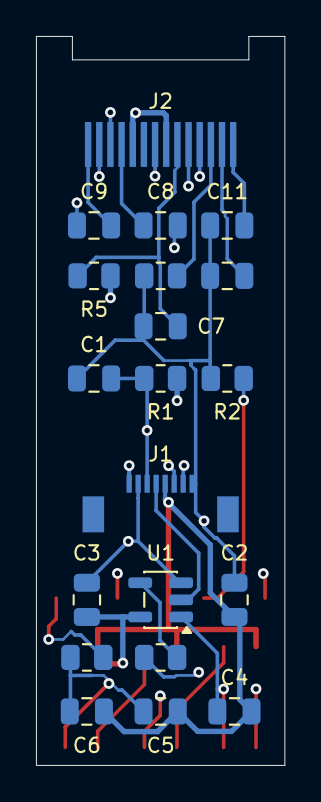
[picture p72: board ui.kicad_pcb from below]

Board: 4 copper layers, 13.8 x 40.5 mm, 25 parts (20 on the bottom side), 21 nets.

Parts:
C1, C3, C4, C5, C6, C7: 100n 50V; C_0805_2012Metric
C2, C8, C9, C10, C11: 1u 50V; C_0805_2012Metric
D1, D2, D3: WS2812B-MINI-V3J; LED_WS2812B-MINI-V3J
J1: FPC-05F-8PH20; FPC_Kinghelm_KH-FPC0.5-H1.2SMT-8P
J2: OLED; OLED_FPC_14P_P0.62mm_Hotbar
R1, R3, R5: 10k; R_0805_2012Metric
R2: 20k; R_0805_2012Metric
R4: 330R; R_0805_2012Metric
R6: 390k; R_0805_2012Metric
SW1, SW2: B3U-1000P; SW_SPST_B3U-1000P
U1: 74AHCT1G125; SOT-23-5

Connections:
+3V3: J1.1, J2.5, J2.8, R1.1, R5.1
+5V: C2.1, C3.1, C4.1, C5.1, C6.1, D1.1, D2.1, D3.1, J1.5, U1.5
BTN_LADDER: C1.1, J1.3, R1.2, SW1.1, SW2.1
GND: C1.2, C2.2, C3.2, C4.2, C5.2, C6.2, C7.2, C10.2, C11.2, D1.3, D2.3, D3.3, J1.2, J1.8, J2.7, R2.2, R3.2, R6.2, U1.1, U1.3
I2C_SCL: J1.7, J2.10
I2C_SDA: J1.6, J2.11
LED_CHAIN1: D1.2, D2.4
LED_CHAIN2: D2.2, D3.4
LED_DATA: J1.4, U1.2
unnamed: R2.1, SW1.2
unnamed: R3.1, SW2.2
unnamed: R4.1, U1.4
unnamed: D1.4, R4.2
OLED_C1N: C8.2, J2.4
OLED_C1P: C8.1, J2.3
OLED_C2N: C9.2, J2.2
OLED_C2P: C9.1, J2.1
OLED_IREF: J2.12, R6.1
OLED_RES: C7.1, J2.9, R5.2
OLED_VCOMH: C10.1, J2.13
OLED_VOUT: C11.1, J2.14
