vbartusevicius/esp-measurement-platform/hardware/layout/v1/reader/reader.kicad_pcb

## KiCad design hardware/layout/v1/reader/reader.kicad_pcb (2026-11-11)

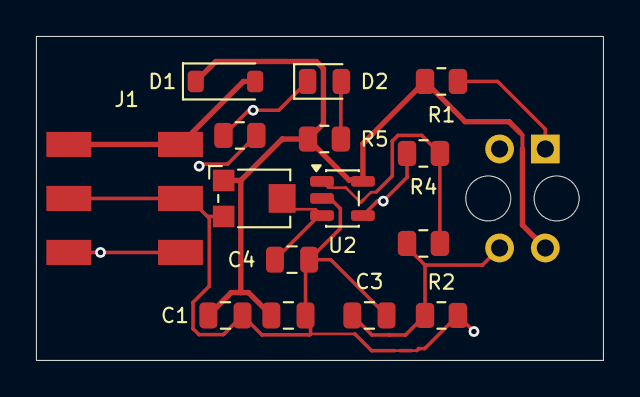
[picture p73: board reader.kicad_pcb from above]

Board: 4 copper layers, 31.5 x 18.0 mm, 16 parts (1 on the bottom side), 10 nets.

Parts:
C1: 10u 25V; C_0805_2012Metric
C2, C3, C4: 100n 50V; C_0805_2012Metric
D1: B5819W; D_SOD-123
D2: red; LED_0805_2012Metric
J1: 2059-303/998-403; TerminalBlock_WAGO_2059-303_SMD
R1: 220R; R_0805_2012Metric
R2: 4k7; R_0805_2012Metric
R3: 10k; R_0805_2012Metric
R4: 390k; R_0805_2012Metric
R5: 1k; R_0805_2012Metric
R6: 330R; R_0805_2012Metric
RV1: 10k; Potentiometer_Bourns_TC33X_Vertical
U1: TCRT5000; Vishay_TCRT5000_Clips
U2: LMV331; SOT-23-5

Connections:
+5V_IN: D1.2, J1.1
+5V_S: C1.1, C2.1, D1.1, R1.1, R5.1, RV1.1, U1.3, U2.5
CMP_OUT: D2.1, R4.1, R6.1, U2.4
GND: C1.2, C2.2, C3.2, C4.2, J1.2, R2.2, RV1.3, U1.2, U2.2
IR_A: R1.2, U1.1
LED_A: D2.2, R5.2
PULSE: J1.3, R6.2
SENSE: C3.1, R2.1, R3.1, U1.4
SENSE_IN: R3.2, R4.2, U2.1
THRESHOLD: C4.1, RV1.2, U2.3
