vbartusevicius/esp-measurement-platform/hardware/circuits/blocks/power_24v.py

"""24 V DC input protection + loop power pass-through + SCT2601 5 V 600 mA buck converter.

Input range: 9-30 V DC (nominal 24 V DC).
  J1 pin 2 (VIN_RAW) -> F1 (1.1 A 33 V 1812 PTC resettable fuse) -> VIN_FUSED
  D2 (SS36 60 V 3 A Schottky diode) blocks reverse polarity -> +24V_LOOP
  D1 (SMAJ30A unidirectional TVS across +24V_LOOP..GND): 30 V stand-off,
  48.4 V clamp at 8.3 A, below the 50 V input capacitors and the SCT2601's
  65 V VIN/SW absolute maximum (SCT2400 was 42 V, below the old SMAJ33A's
  53.3 V clamp).
  +24V_LOOP feeds both the top sensor terminal J2 pin 3 (for 2-wire 4-20 mA
  transmitters like SWK-LT100) and the SCT2601 5 V 600 mA step-down converter.
"""

from common import block, part, power_flag, src
from skidl import Net

R0603 = "Resistor_SMD:R_0805_2012Metric"   # 0805 throughout: hand-soldered
C0603 = "Capacitor_SMD:C_0805_2012Metric"
C0805 = "Capacitor_SMD:C_0805_2012Metric"
SMA = "Diode_SMD:D_SMA"
FUSE_1812 = "Fuse:Fuse_1812_4532Metric"
TSOT23_6 = "Package_TO_SOT_SMD:TSOT-23-6"


def res(value, fields=None, footprint=R0603):
    return part("Device", "R", value, footprint, fields)


def cap(value, fields=None, footprint=C0603):
    return part("Device", "C", value, footprint, fields)


def build(gnd):
    vin_raw = Net("VIN_RAW")
    vin_fused = Net("VIN_FUSED")
    v24_loop = Net("+24V_LOOP")
    v5 = Net("+5V")
    sw = Net("BUCK5_SW")

    block("pwr_in")
    f1 = part("Device", "Polyfuse", "1.1A", FUSE_1812,
              src(mpn="1812L110/33MR", mfr="Littelfuse", lcsc="C142747",
                  source="1.1 A hold / 2.2 A trip 33 V 1812 PTC resettable fuse on 24 V input"),
              ref="F1")
    f1[1] += vin_raw
    f1[2] += vin_fused

    d2 = part("Device", "D_Schottky", "SS36", SMA,
              src(mpn="SS36", mfr="MDD", lcsc="C16015",
                  source="60 V 3 A reverse-polarity blocking Schottky diode"),
              ref="D2")
    d2["A"] += vin_fused
    d2["K"] += v24_loop
    power_flag(v24_loop)

    d1 = part("Device", "D_Zener", "SMAJ30A", SMA,
              src(mpn="SMAJ30A", mfr="MDD", lcsc="C113965",
                  source="30 V stand-off / 48.4 V clamp unidirectional TVS after reverse diode"),
              ref="D1")
    d1["A"] += gnd
    d1["K"] += v24_loop

    # --- 24 V -> 5 V 600 mA asynchronous buck (SCT2601TVBR, 4.5-60 V input, 65 V abs max, 700 kHz) ---
    block("buck5v")
    u1 = part("gateway", "SCT2601", "SCT2601TVBR", TSOT23_6,
              src(mpn="SCT2601TVBR", mfr="SCT", lcsc="C2931912",
                  source="SCT2601 datasheet: 4.5-60 V in (65 V abs max), 600 mA, 700 kHz, 80 ns min on-time"),
              ref="U1")
    u1["VIN"] += v24_loop
    u1["GND"] += gnd

    # UVLO divider: 100k / 20k -> 1.223 V * 6 - 1 uA * 100k = ~7.2 V turn-on (12 V and 24 V supplies)
    r_en_top = res("100k", src(source="SCT2601 EN UVLO top"))
    r_en_top[1] += v24_loop
    r_en_top[2] += u1["EN"]
    r_en_bot = res("20k", src(source="SCT2601 EN UVLO bottom"))
    r_en_bot[1] += u1["EN"]
    r_en_bot[2] += gnd

    c_bst = cap("100n 50V", src(source="SCT2601 BST bootstrap cap"))
    c_bst[1] += u1["BST"]
    c_bst[2] += sw
    sw += u1["SW"]

    d_catch = part("Device", "D_Schottky", "SS36", SMA,
                   src(mpn="SS36", mfr="MDD", lcsc="C16015",
                       source="SCT2601 external catch diode SW -> GND (>= 60 V per datasheet)"),
                   ref="D9")
    d_catch["A"] += gnd
    d_catch["K"] += sw

    # FNR4020S is a 4x4x2.0 mm drop-in for Sunlord SWPA4020S220MT (C82401), which LCSC does not sell
    l1 = part("Device", "L", "22uH", "Inductor_SMD:L_Sunlord_SWPA4020S",
              src(mpn="FNR4020S220MT", mfr="Changjiang Microelectronics", lcsc="C167838",
                  source="SCT2601 table 2: 22 uH for 5 V out; 1.1 A Isat, 0.87 A Irms, 455 mOhm, 4x4x2 mm shielded"),
              ref="L1")
    l1[1] += sw
    l1[2] += v5
    power_flag(v5)

    # FB divider: VOUT = 0.765 V * (1 + 56k / 10k) = 5.05 V
    r_fb_top = res("56k", src(source="SCT2601 FB top: 5.05 V output"))
    r_fb_top[1] += v5
    r_fb_top[2] += u1["FB"]
    r_fb_bot = res("10k", src(source="SCT2601 FB bottom"))
    r_fb_bot[1] += u1["FB"]
    r_fb_bot[2] += gnd

    for _ in range(2):
        c_in = cap("10u 50V", src(source="SCT2601 24 V input decoupling"), footprint=C0805)
        c_in[1] += v24_loop
        c_in[2] += gnd
    c_in_hf = cap("100n 50V", src(source="SCT2601 HF input decoupling"))
    c_in_hf[1] += v24_loop
    c_in_hf[2] += gnd

    for val in ("22u 25V", "22u 25V", "100n 50V"):
        c_out = cap(val, src(source="SCT2601 5 V output decoupling"),
                    footprint=C0805 if "22u" in val else C0603)
        c_out[1] += v5
        c_out[2] += gnd

    return {"vin_raw": vin_raw, "v24_loop": v24_loop, "v5": v5}
