vbartusevicius/esp-measurement-platform/test/test_native/test_analog_sensor_converter.cpp

#include <gtest/gtest.h>
#include "AnalogSensorConverter.h"

// Constants matching AnalogDistancePlugin
static constexpr float MIN_MA = 4.0f;
static constexpr float MAX_MA = 20.0f;
static constexpr float FAULT_MA = 3.6f;   // NAMUR NE43

// --- shuntMillivoltsToCurrentMA (v1 board: 120R shunt) ---

TEST(AnalogSensorConverter, ShuntFourMilliampsReads480mV)
{
    EXPECT_FLOAT_EQ(AnalogSensorConverter::shuntMillivoltsToCurrentMA(480, 120.0f), 4.0f);
}

TEST(AnalogSensorConverter, ShuntTwentyMilliampsReads2400mV)
{
    EXPECT_FLOAT_EQ(AnalogSensorConverter::shuntMillivoltsToCurrentMA(2400, 120.0f), 20.0f);
}

TEST(AnalogSensorConverter, ShuntNamurFaultCurrentStaysInsideAdcRange)
{
    EXPECT_FLOAT_EQ(AnalogSensorConverter::shuntMillivoltsToCurrentMA(2880, 120.0f), 24.0f);
}

TEST(AnalogSensorConverter, ShuntOpenLoopOrNoShuntReadsZero)
{
    EXPECT_FLOAT_EQ(AnalogSensorConverter::shuntMillivoltsToCurrentMA(0, 120.0f), 0.0f);
    EXPECT_FLOAT_EQ(AnalogSensorConverter::shuntMillivoltsToCurrentMA(-5, 120.0f), 0.0f);
    EXPECT_FLOAT_EQ(AnalogSensorConverter::shuntMillivoltsToCurrentMA(1000, 0.0f), 0.0f);
}

// --- currentToDistance ---

TEST(AnalogSensorConverter, MinCurrentReturnsZeroDistance)
{
    float dist = AnalogSensorConverter::currentToDistance(MIN_MA, MIN_MA, MAX_MA, 5.0);
    EXPECT_FLOAT_EQ(dist, 0.0f);
}

TEST(AnalogSensorConverter, MaxCurrentReturnsFullRange)
{
    float dist = AnalogSensorConverter::currentToDistance(MAX_MA, MIN_MA, MAX_MA, 5.0);
    EXPECT_FLOAT_EQ(dist, 5.0f);
}

TEST(AnalogSensorConverter, MidCurrentReturnsMidRange)
{
    float midCurrent = (MIN_MA + MAX_MA) / 2.0f;
    float dist = AnalogSensorConverter::currentToDistance(midCurrent, MIN_MA, MAX_MA, 5.0);
    EXPECT_NEAR(dist, 2.5f, 0.01f);
}

TEST(AnalogSensorConverter, DifferentSensorRange)
{
    float dist = AnalogSensorConverter::currentToDistance(MAX_MA, MIN_MA, MAX_MA, 10.0);
    EXPECT_FLOAT_EQ(dist, 10.0f);
}

// --- isSensorConnected ---

TEST(AnalogSensorConverter, ConnectedAboveFaultThreshold)
{
    EXPECT_TRUE(AnalogSensorConverter::isSensorConnected(5.0, FAULT_MA));
}

TEST(AnalogSensorConverter, DisconnectedBelowFaultThreshold)
{
    EXPECT_FALSE(AnalogSensorConverter::isSensorConnected(3.5, FAULT_MA));
}

TEST(AnalogSensorConverter, ConnectedExactlyAtFaultThreshold)
{
    EXPECT_TRUE(AnalogSensorConverter::isSensorConnected(FAULT_MA, FAULT_MA));
}
