vbartusevicius/esp-measurement-platform/test/test_native/calculator_sources.cpp

// Compile calculator and plugin implementations for the native test environment.
// The plugin code compiles against the fakes in test_native/fakes.
#include "../../lib/Plugins/AnalogDistance/AnalogDistanceCalculator.cpp"
#include "../../lib/Plugins/AnalogDistance/AnalogSensorConverter.cpp"
#include "../../lib/Plugins/UltrasonicDistance/UltrasonicDistanceCalculator.cpp"
#include "../../lib/Plugins/RadiationCounter/RadiationCalculator.cpp"
#include "../../lib/Plugin/FlowRateCalculator.cpp"
#include "../../lib/Plugin/LevelFilter.cpp"
#include "../../lib/Plugin/DailyUsageTracker.cpp"
#include "../../lib/Plugin/HaDiscovery.cpp"
#include "../../lib/Core/ButtonLadder.cpp"
#include "../../lib/Core/RelayOutput.cpp"
#include "../../lib/Core/LimitMonitor.cpp"
#include "../../lib/Core/EventLog.cpp"
#include "../../lib/Core/DeviceMonitor.cpp"
#include "../../lib/Plugin/TrendBuffer.cpp"
#include "../../lib/Plugin/RollingExtremes.cpp"
#include "../../lib/Plugins/AnalogVoltage/AnalogVoltageConverter.cpp"

// Plugin implementations under test
#include "../../lib/Plugins/DistanceBase/DistancePluginBase.cpp"
#include "../../lib/Plugins/AnalogDistance/AnalogDistancePlugin.cpp"
#include "../../lib/Plugins/AnalogVoltage/AnalogVoltagePlugin.cpp"
#include "../../lib/Plugins/UltrasonicDistance/UltrasonicDistancePlugin.cpp"
#include "../../lib/Plugins/RadiationCounter/RadiationCounterPlugin.cpp"
#include "../../lib/Plugins/PulseMeter/PulseMeterPlugin.cpp"
