vbartusevicius/esp-measurement-platform/test/test_native/test_analog_voltage_plugin.cpp

#include <gtest/gtest.h>
#include "AnalogVoltagePlugin.h"
#include "HAL.h"
#include "Storage.h"
#include "Logger.h"

class VoltageHal : public HAL {
public:
    int millivolts = 0;
    void pinMode(uint8_t, uint8_t) override {}
    int analogReadMilliVolts(uint8_t) override { return millivolts; }
    unsigned long millis() override { return FakeHAL::currentMillis; }
};

class AnalogVoltagePluginTest : public ::testing::Test {
protected:
    VoltageHal hal;
    Storage storage;
    Logger logger;
    AnalogVoltagePlugin plugin;

    void SetUp() override {
        storage.begin();
        storage.reset();
        FakeHAL::currentMillis = 0;
    }
};

TEST_F(AnalogVoltagePluginTest, DefaultsMapAHalfScalePressureTransducer)
{
    // 781 mV at the ADC x 3.2 (22k/10k divider) = 2.5 V: mid-scale of 0.5-4.5 V / 0-10 bar
    hal.millivolts = 781;
    plugin.setup(&hal, &storage, &logger, nullptr);
    plugin.loop();

    ScreenModel screen;
    ASSERT_TRUE(plugin.getScreen(screen));
    EXPECT_STREQ(screen.title, "PRES");
    EXPECT_STREQ(screen.unit, "bar");
    EXPECT_NEAR(screen.value, 5.0f, 0.01f);
    EXPECT_TRUE(screen.valid);
    EXPECT_STREQ(screen.signal.c_str(), "2.50V");
    EXPECT_FLOAT_EQ(screen.scaleMax, 10.0f);
}

TEST_F(AnalogVoltagePluginTest, OpenWireIsAFault)
{
    hal.millivolts = 10;
    plugin.setup(&hal, &storage, &logger, nullptr);
    plugin.loop();

    ScreenModel screen;
    plugin.getScreen(screen);
    EXPECT_FALSE(screen.valid);
    EXPECT_FALSE(screen.sensorOk);
}

TEST_F(AnalogVoltagePluginTest, CustomRangeUnitAndTitle)
{
    storage.saveParameter(AnalogVoltagePlugin::PARAM_VOLTAGE_MIN, String("0"));
    storage.saveParameter(AnalogVoltagePlugin::PARAM_VOLTAGE_MAX, String("3.2"));
    storage.saveParameter(AnalogVoltagePlugin::PARAM_VALUE_MAX, String("150"));
    storage.saveParameter(AnalogVoltagePlugin::PARAM_VALUE_UNIT, String("psi"));
    storage.saveParameter(AnalogVoltagePlugin::PARAM_TITLE, String("PUMPX"));
    hal.millivolts = 500;   // 1.6 V input = half of 0-3.2 V
    plugin.setup(&hal, &storage, &logger, nullptr);
    plugin.loop();

    ScreenModel screen;
    plugin.getScreen(screen);
    EXPECT_STREQ(screen.title, "PUMP");
    EXPECT_STREQ(screen.unit, "psi");
    EXPECT_NEAR(screen.value, 75.0f, 0.01f);
}

TEST_F(AnalogVoltagePluginTest, KindFollowsTheUnit)
{
    hal.millivolts = 781;
    plugin.setup(&hal, &storage, &logger, nullptr);
    plugin.loop();
    ScreenModel pressure;
    plugin.getScreen(pressure);
    EXPECT_STREQ(pressure.kind, "pressure");

    storage.saveParameter(AnalogVoltagePlugin::PARAM_VALUE_UNIT, String("%RH"));
    plugin.setup(&hal, &storage, &logger, nullptr);
    plugin.loop();
    ScreenModel generic;
    plugin.getScreen(generic);
    EXPECT_STREQ(generic.kind, "voltage");
}
