vbartusevicius/esp-measurement-platform/(commit log)

2026-04-12 add IDE setup documentation, refactor plugin interface with default methods for display page and sampling interval, move radiation counter interrupts into plugin class
2026-04-14 refactor AnalogDistancePlugin and RadiationCounterPlugin to use HAL abstraction layer, extract calculation logic into separate AnalogDistanceCalculator, AnalogSensorConverter, and RadiationCalculator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
2026-04-14 add GitHub Actions test job with Docker-based native tests, update README with testing documentation, add unsigned int hex constructor to fake String class, fix aggregate test parameters
    [test_distance_calculator.cpp]
2026-04-14 feat: add support for unconfigured devices by making plugin selection optional across backend and frontend
2026-07-19 add flow rate calculation
2026-07-19 fix restart loop, fix LED blink
    [main.cpp, test_flow_rate_calculator.cpp]
2026-09-03 refactor plugin architecture to separate MQTT and display concerns (#1)
    * refactor plugin architecture to separate MQTT and display concerns, replace vector-based log buffer with fixed-size circular buffer, move display initialization to begin method, and extract sensor calculation logic from plugin loop
    * add comprehensive MQTT improvements, Home Assistant integration, and web UI chart support
    - implement MQTT zombie connection detection with 90s timeout and forced reconnection
    - add system diagnostic sensors (heap, RSSI, uptime, firmware version) to Home Assistant
    - publish unified status messages with JSON payload instead of simple string
    - subscribe to own status topic for end-to-end c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
    [calculator_sources.cpp, main.cpp, test_analog_distance_plugin.cpp]
2026-09-04 replace MovingAverageFilter with LevelFilter implementing deadband-based level change detection
    [calculator_sources.cpp, test_distance_calculator.cpp, test_level_filter.cpp]
2026-09-04 refactor OTA update mechanism to use boot-time installation with RTC state persistence, add MFLN probing for optimal TLS buffer sizing, and implement comprehensive error tracking across reboot cycles
    [main.cpp]
2026-09-04 add debug log suppression to prevent websocket overload, defer OTA checks while web UI is active, limit log batch sizes to avoid heap exhaustion
    [main.cpp, test_logger.cpp]
2026-09-04 replace Preferences library with custom EEPROM-based storage implementation using binary layout with magic header, entry count, and length-prefixed key-value pairs
    [test_analog_distance_plugin.cpp, test_storage.cpp]
2026-09-04 add filesystem version tracking, automatic repair on firmware-filesystem mismatch, and failure-limited retry logic for OTA updates
    [main.cpp]
2026-09-04 replace automatic OTA update system with manual web-based firmware upload, remove ReleaseUpdater class and GitHub release checking, add HTTP multipart upload endpoint for firmware and filesystem bina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
    [main.cpp, test_storage.cpp]
2026-09-04 rename lastMqttActivity to lastStatusPublish, increase status publish interval from 15s to 30s, remove version sensor from Home Assistant diagnostics
2026-09-05 refactor MQTT topic structure to use device name as root, replace hardcoded esp/<chip_id> paths with <device_name>/{stat,diag,availability}, pass availability topic through HaDiscoveryContext to all 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
2026-09-05 add user-configurable device name field to web UI and pass through HaDiscoveryContext, replace hardcoded plugin names in Home Assistant discovery with ctx.nameOr() fallback helper
    [test_ha_discovery_context.cpp]
2026-09-05 set number input step to 'any' to allow decimal values in plugin parameters like alert thresholds and tube factors
2026-10-17 mechanical assembly
2026-10-17 replace SS16 Schottky diodes with SS34
2026-10-23 pin PlatformIO to 6.1.19 to avoid ESP8266 build failures in 6.2.0, add xiao_c6 build target to CI workflow with filesystem build step, update README with v1 board hardware details and Docker build in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
2026-10-23 remove filesystem build steps from CI and release workflows, embed web UI into firmware binary via WebAssets.h generated by embed_web.py, update Docker and README instructions to remove buildfs comma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
2026-10-23 update web UI and API to use /api/v1/alert/ack endpoint, add configured flag to status response, refactor Display class to extract PortraitPages helper, remove Board HAS_* constants (rely on pin defi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
2026-10-23 remove documentation images (admin dashboard, analog sensor diagrams, Home Assistant device screenshots, NodeMCU pinout, OLED portrait mockups)
2026-10-23 update README with detailed sensor wiring and setup instructions for each plugin type (ultrasonic, 4-20mA, pressure, radiation counter), add terminal reference table, expand fault detection and safet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
2026-10-26 refactor to multi-sensor firmware
2026-10-27 remove cover_color.3mf and cover_color_obj.zip from enclosure, add ODB++/IPC-2581/fab-neutral BOM+CPL exports for main board
2026-10-27 pin CI and release workflows to Python 3.12 to match Dockerfile.firmware, add comment noting pioarduino 55.03.311 accepts 3.10-3.14
2026-10-29 replace LCSC-unavailable parts, update assembly_parts.yaml with LCSC/Mouser/Digi-Key numbers, add parts ordering documentation to v1 README
2026-10-29 extend GND track joints on main board to fully seat on pads/vias
2026-10-30 add Mouser column to order_elsewhere.csv, include XIAO ESP32C6 module with Mouser/Digi-Key numbers, remove OLED backing foam line
2026-11-09 replace main-board terminals with WAGO 2086-1202 and Degson DG127R screw terminal, update layout and 3D models, add mechanical enclosure/print-rule tests to CI, refresh documentation images and manuf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
2026-11-09 refresh hardware and WebUI documentation screenshots for the box, enclosure, hero, desktop, events, radiation, and tank views
2026-11-09 compare released enclosure files against fresh CAD exports instead of git-ignored build artifacts for both case variants
2026-11-09 compare released case STL geometry against fresh CAD exports using volume and bounding-box tolerances instead of byte equality
2026-11-11 replace the XIAO ideal diode with a hand-solderable SS34, switch UI LEDs to WS2812B-MINI-V3J and update their layout, standardize hand-soldered passives on 0805, refresh PCB layouts and documentation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
2026-11-11 update button markings and documentation, replace dial-reader Schottky diode with MDD B5819W, remove embossed-cover references and refresh product images and assembly model
2026-11-11 Remove button labels in favor of button markings
2026-11-11 shift box enclosure fastener geometry 0.2 mm and refresh dial-reader assembly STEP export appearance
2026-11-11 remove assembly-drawing tests for part placement and release PDFs
2026-11-11 add assembly-drawing checks to CI and refresh main-board release files after removing panel mouse-bite footprint metadata
